CodethinkLabs/bloodlight-hardware/hardware/plots/rev2/bloodlight_2_bottom.png

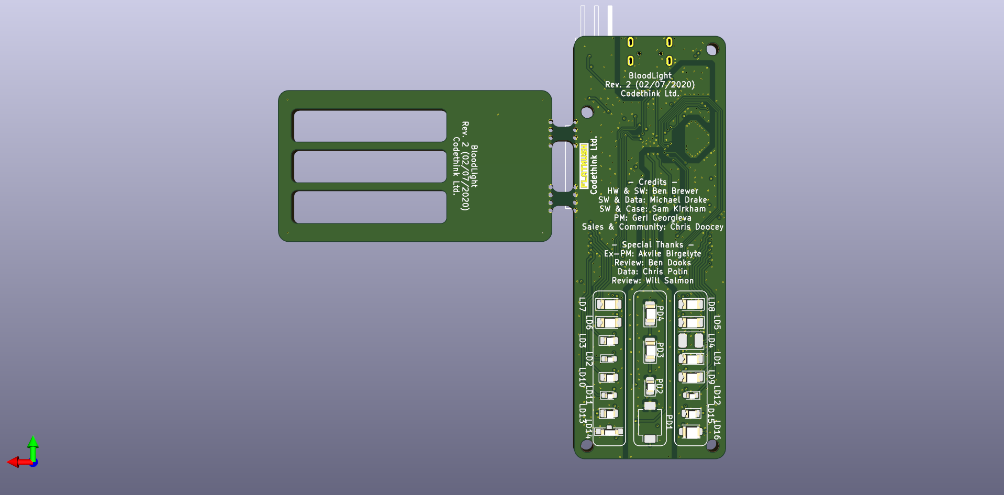
hardware/plots/rev2/bloodlight_2_bottom.png
