CodethinkLabs/bloodlight-hardware/hardware/plots/rev2/bloodlight_2_top.png

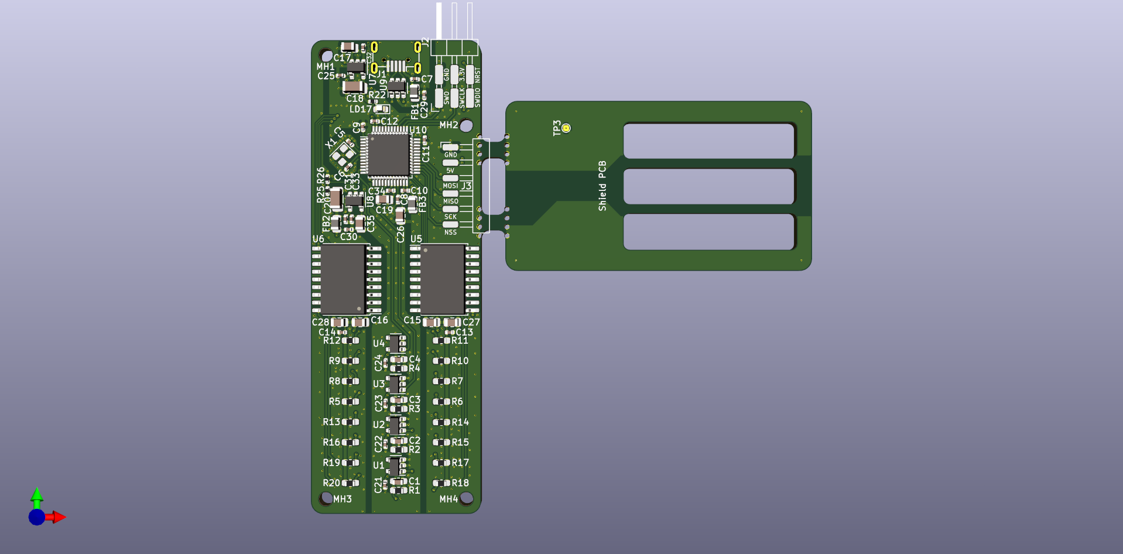
hardware/plots/rev2/bloodlight_2_top.png
