CodethinkLabs/bloodlight-hardware/hardware/pin_alloc.txt

# SIGNALS

VOLT:   VOLT_5V0
LED:    LED1..LED16, LED_STATUS
PD:     PDV1..PDV4
EXT:    SPI2_NSS, SPI2_SCK, SPI2_MISO, SPI2_MOSI
DEBUG:  SWCLK, SWDIO, SWO, NRST
USB:    USB_DP, USB_DM

# PINS

 1: VBAT
 2: PC13: LED2
 3: PC14: LED1
 4: PC15: LED11
 5: PF0 : OSC_IN
 6: PF1 : OSC_OUT
 7: PG10: NRST
 8: PA0 : LED12
 9: PA1 : LED15
10: PA2 : LED16
11: PA3 : PDV4 (ADC1_IN4, OPAMP1_VINM, OPAMP5_VINM)
12: PA4 : Not Connected (Isolation)
13: PA5 : LED8
14: PA6 : LED5
15: PA7 : VOLT_5V0 (ADC2_IN4, OPAMP1_VINP, OPAMP2_VINP)
16: PB0 : Not Connected (Isolation)
17: PB1 : PDV3 (ADC3_IN1, ADC1_IN12, OPAMP6_VINM)
18: PB2 : PDV1 (ADC2_IN12, OPAMP3_VINM)
19: VSSA
20: VREF+
21: VDDA
22: PB10: PDV2 (OPAMP3_VINM, OPAMP4_VINM)
23: VSS
24: VDD
25: PB11: LED3
26: PB12: SPI2_NSS
27: PB13: SPI2_SCK
28: PB14: SPI2_MISO
29: PB15: SPI2_MOSI (OPAMP5_VINM)
30: PA8 : LED6
31: PA9 : LED7
32: PA10: LED4
33: PA11: USB_DM
34: PA12: USB_DP
35: VSS
36: VDD
37: PA13: SWDIO
38: PA14: SWCLK
39: PA15: LED13
40: PB3 : SWO
41: PB4 : LED14
42: PB5 : LED9
43: PB6 : LED10
44: PB7 : LED_STATUS
45: PB8 : Unallocated (BOOT0)
46: PB9 : Unallocated
47: VSS
48: VDD
