CodethinkLabs/bloodlight-hardware/hardware/plots/rev2/bloodlight_2_angle.png

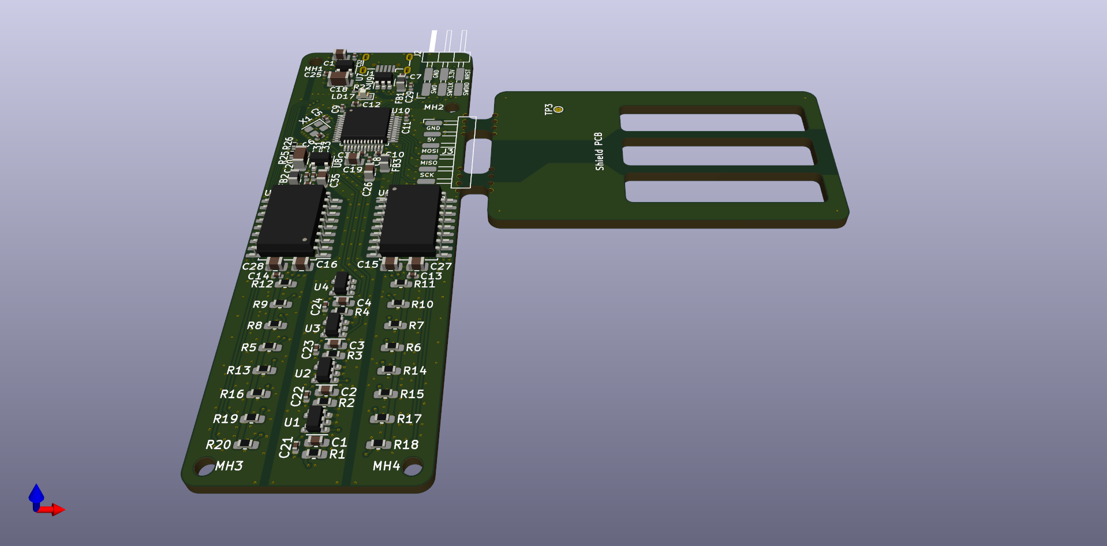
hardware/plots/rev2/bloodlight_2_angle.png
