CodethinkLabs/bloodlight-hardware/doc/LED.ods

Sheet: Components
Wavelength (nm) | Color | Price (£) | Availability | Voltage | Current (mA) | Power (mW) | Length (mm) | Width (mm) | Height (mm) | PD1 | PD2 | PD3 | PD4 | Photodiode | Selected | Category | URL
1650 | SWIR | £17.00 | 38 | 1.00 | 50 | 50 | 3.20 | 1.60 | 1.20 | 0.00 | 0.00 | 0.00 | 0.73 | PD4 | LD8 | Infrared, UV, Visible Emitters | https://www.digikey.co.uk/product-detail/en/marktech-optoelectronics/MTSM5016-199-IR/1125-1354-ND/5872623
1550 | SWIR | £17.00 | 323 | 1.00 | 50 | 50 | 3.20 | 1.60 | 1.20 | 0.00 | 0.00 | 0.00 | 0.96 | PD4 | LD7 | Infrared, UV, Visible Emitters | https://www.digikey.co.uk/product-detail/en/marktech-optoelectronics/MTSM5015-199-IR/1125-1350-ND/5872619
1500 | SWIR | £18.59 | 1,240 | 1.05 | 50 | 52.5 | 3.30 | 3.30 | 1.95 | 0.00 | 0.00 | 0.00 | 0.95 | PD4 |  | Infrared, UV, Visible Emitters | https://www.digikey.co.uk/product-detail/en/qt-brightek-qtb/QBHP684E-IR1500B/1516-QBHP684E-IR1500BCT-ND/10441186
1450 | SWIR | £17.00 | 30 | 1.00 | 50 | 50 | 3.20 | 1.60 | 1.20 | 0.00 | 0.00 | 0.00 | 0.94 | PD4 | LD6 | Infrared, UV, Visible Emitters | https://www.digikey.co.uk/product-detail/en/marktech-optoelectronics/MTSM5014-199-IR/1125-1346-ND/5872615
1300 | NIR | £17.00 | 4 | 1.00 | 50 | 50 | 3.20 | 1.60 | 1.20 | 0.00 | 0.00 | 0.00 | 0.86 | PD4 |  | Infrared, UV, Visible Emitters | https://www.digikey.co.uk/product-detail/en/marktech-optoelectronics/MTSM0013-199-IR/1125-1335-ND/5872604
1300 | NIR | £14.07 | 200 | 1.03 | 50 | 51.5 | 3.50 | 2.70 | 1.80 | 0.00 | 0.00 | 0.00 | 0.86 | PD4 |  | Infrared, UV, Visible Emitters | https://www.digikey.co.uk/product-detail/en/marktech-optoelectronics/MTSM1300MT2-BK/1125-MTSM1300MT2-BKCT-ND/11307539
1200 | NIR | £17.00 | 94 | 1.00 | 50 | 50 | 3.20 | 1.60 | 1.20 | 0.00 | 0.00 | 0.00 | 0.80 | PD4 | LD5 | Infrared, UV, Visible Emitters | https://www.digikey.co.uk/product-detail/en/marktech-optoelectronics/MTSM0012-199-IR/1125-1331-ND/5872600
1070 | NIR | £14.07 | 200 | 1.32 | 100 | 132 | 3.50 | 2.70 | 1.80 | 0.04 | 0.14 | 0.39 | 0.69 | PD4 |  | Infrared, UV, Visible Emitters | https://www.digikey.co.uk/product-detail/en/marktech-optoelectronics/MTSM7110MT2-BK/1125-MTSM7110MT2-BKCT-ND/11307532
1050 | NIR | £15.05 | 124 | 1.20 | 50 | 60 | 3.20 | 1.60 | 1.20 | 0.05 | 0.21 | 0.54 | 0.68 | PD4 |  | Infrared, UV, Visible Emitters | https://www.digikey.co.uk/product-detail/en/marktech-optoelectronics/MTSM5010-199-IR/1125-1342-ND/5872611
1040 | NIR | £14.07 | 200 | 1.03 | 100 | 103 | 3.50 | 2.70 | 1.80 | 0.05 | 0.24 | 0.62 | 0.67 | PD4 | LD4 | Infrared, UV, Visible Emitters | https://www.digikey.co.uk/product-detail/en/marktech-optoelectronics/MTSM4110MT2-BK/1125-MTSM4110MT2-BKCT-ND/11307533
1020 | NIR | £37.48 | 47 | 1.00 | 500 | 500 | 3.80 | 3.80 | 0.90 | 0.05 | 0.30 | 0.77 | 0.66 | PD3 |  | Infrared, UV, Visible Emitters | https://www.digikey.co.uk/product-detail/en/marktech-optoelectronics/MTSM2010-496-IR/1125-1358-ND/5872627
980 | NIR | £33.05 | 9 | 1.45 | 30 | 43.5 | 3.50 | 2.20 | 1.24 | 0.07 | 0.46 | 0.95 | 0.57 | PD3 |  | Infrared, UV, Visible Emitters | https://www.digikey.co.uk/product-detail/en/marktech-optoelectronics/MTPS2097MC/1125-1451-ND/9598984
980 | NIR | £43.97 | 39 | 2.00 | 80 | 160 | 3.50 | 2.20 | 1.91 | 0.07 | 0.46 | 0.95 | 0.57 | PD3 |  | Infrared, UV, Visible Emitters | https://www.digikey.co.uk/product-detail/en/marktech-optoelectronics/MTE9730CP/1125-1435-ND/8566064
950 | NIR | £0.84 | 14,970 | 1.60 | 70 | 112 | 3.10 | 2.25 | 1.60 | 0.08 | 0.60 | 0.99 | 0.46 | PD3 |  | Infrared, UV, Visible Emitters | https://www.digikey.co.uk/product-detail/en/osram-opto-semiconductors-inc/SFH-4641-Z/475-2872-1-ND/2207278
940 | NIR | £0.39 | 270,682 | 1.20 | 65 | 78 | 2.00 | 1.25 | 1.00 | 0.08 | 0.65 | 1.00 | 0.42 | PD3 | LD3 | Infrared, UV, Visible Emitters | https://www.digikey.co.uk/product-detail/en/everlight-electronics-co-ltd/IR17-21C-TR8/1080-1353-1-ND/2676087
890 | NIR | £0.88 | 2,918 | 1.80 | 100 | 180 | 2.00 | 1.25 | 0.80 | 0.12 | 0.85 | 0.95 | 0.33 | PD3 |  | Infrared, UV, Visible Emitters | https://www.digikey.co.uk/product-detail/en/vishay-semiconductor-opto-division/VSMY5890X01/751-VSMY5890X01CT-ND/10658274
880 | NIR | £0.43 | 6,807 | 1.30 | 50 | 65 | 1.60 | 0.80 | 0.75 | 0.13 | 0.87 | 0.94 | 0.30 | PD3 | LD2 | Infrared, UV, Visible Emitters | https://www.digikey.co.uk/product-detail/en/kingbright/APT1608SF4C-PRV/754-1859-1-ND/4977031
875 | NIR | £0.36 | 2,075 | 1.30 | 65 | 84.5 | 1.20 | 0.80 | 0.80 | 0.13 | 0.88 | 0.93 | 0.29 | PD3 |  | Infrared, UV, Visible Emitters | https://www.digikey.co.uk/product-detail/en/everlight-electronics-co-ltd/SIR19-21C-TR8/1080-1425-1-ND/2676159
870 | NIR | £0.59 | 4,980 | 1.40 | 50 | 70 | 3.00 | 1.50 | 1.50 | 0.14 | 0.89 | 0.93 | 0.28 | PD3 |  | Infrared, UV, Visible Emitters | https://www.digikey.co.uk/product-detail/en/stanley-electric-co/TDN1101W-TR/404-1285-1-ND/9477290
860 | NIR | £0.93 | 363,442 | 1.50 | 100 | 150 | 1.70 | 0.80 | 0.65 | 0.15 | 0.92 | 0.92 | 0.25 | PD2 |  | Infrared, UV, Visible Emitters | https://www.digikey.co.uk/product-detail/en/osram-opto-semiconductors-inc/SFH-4050-Z/475-2864-1-ND/2207282
855 | NIR | £13.36 | 4 | 1.70 | 100 | 170 | 3.50 | 2.20 | 1.24 | 0.15 | 0.93 | 0.91 | 0.24 | PD2 |  | Infrared, UV, Visible Emitters | https://www.digikey.co.uk/product-detail/en/marktech-optoelectronics/MTPS3085MC/1125-1033-ND/2798899
855 | NIR | £3.57 | 400 | 3.20 | 1000 | 3200 | 3.50 | 3.50 | 2.36 | 0.15 | 0.93 | 0.91 | 0.24 | PD2 |  | Infrared, UV, Visible Emitters | https://www.digikey.co.uk/product-detail/en/everlight-electronics-co-ltd/HIR-C19D-1N90-L558-P03-TR/1080-HIR-C19D-1N90-L558-P03-CT-ND/10473839
850 | NIR | £0.54 | 7,135 | 1.45 | 50 | 72.5 | 3.00 | 1.50 | 1.50 | 0.15 | 0.94 | 0.90 | 0.23 | PD2 | LD1 | Infrared, UV, Visible Emitters | https://www.digikey.co.uk/product-detail/en/stanley-electric-co/HDN1102W-TR/404-1329-1-ND/9477334
830 | NIR | £1.15 | 8,016 | 1.50 | 100 | 150 | 3.50 | 2.80 | 1.75 | 0.17 | 0.98 | 0.88 | 0.18 | PD2 |  | Infrared, UV, Visible Emitters | https://www.digikey.co.uk/product-detail/en/vishay-semiconductor-opto-division/VSMG2700-GS08/751-1255-1-ND/1681497
820 | NIR | £5.15 | 2,929 | 3.30 | 500 | 1650 | 3.50 | 3.50 | 2.39 | 0.18 | 1.00 | 0.87 | 0.15 | PD2 |  | Infrared, UV, Visible Emitters | https://www.digikey.co.uk/product-detail/en/osram-opto-semiconductors-inc/SFH-4780S/475-3592-1-ND/9468179
820 | NIR | £5.15 | 1,686 | 3.30 | 500 | 1650 | 3.50 | 3.50 | 1.75 | 0.18 | 1.00 | 0.87 | 0.15 | PD2 |  | Infrared, UV, Visible Emitters | https://www.digikey.co.uk/product-detail/en/osram-opto-semiconductors-inc/SFH-4787S/475-3549-1-ND/9383832
815 | NIR | £3.76 | 987 | 3.00 | 1500 | 4500 | 3.50 | 3.50 | 1.90 | 0.19 | 1.00 | 0.86 | 0.15 | PD2 |  | Infrared, UV, Visible Emitters | https://www.digikey.co.uk/product-detail/en/luminus-devices-inc/SST-10-IRD-B130-S810/1214-SST-10-IRD-B130-S810CT-ND/10521440
810 | NIR | £32.97 | 10 | 1.55 | 80 | 124 | 3.50 | 2.20 | 1.91 | 0.20 | 1.00 | 0.85 | 0.15 | PD2 |  | Infrared, UV, Visible Emitters | https://www.digikey.co.uk/product-detail/en/marktech-optoelectronics/MTE8120CP/1125-1433-ND/8566062
770 | NIR | £2.87 | 842 | 1.70 | 30 | 51 | 3.20 | 1.60 | 1.20 | 0.29 | 0.92 | 0.61 | 0.12 | PD2 |  | Infrared, UV, Visible Emitters | https://www.digikey.co.uk/product-detail/en/marktech-optoelectronics/MTSM0077-843-IR/1125-1337-ND/5872606
740 | Red | £2.87 | 734 | 1.70 | 30 | 51 | 3.20 | 1.60 | 1.20 | 0.36 | 0.85 | 0.40 | 0.10 | PD2 | LD9 | Infrared, UV, Visible Emitters | https://www.digikey.co.uk/product-detail/en/marktech-optoelectronics/MTSM0074-843-IR/1125-1336-ND/5872605
740 | Red | £4.37 | 513 | 1.90 | 700 | 1330 | 3.50 | 3.50 | 2.00 | 0.36 | 0.85 | 0.40 | 0.10 | PD2 |  | Infrared, UV, Visible Emitters | https://www.digikey.co.uk/product-detail/en/qt-brightek-qtb/QBHP684-IR4BU/1516-1213-1-ND/6151901
735 | Red | £2.52 | 1,087 | 1.73 | 350 | 605.5 | 2.00 | 2.00 | 1.50 | 0.37 | 0.84 | 0.36 | 0.10 | PD2 |  | LED Lighting – Color | https://www.digikey.co.uk/product-detail/en/lumileds/L1C1-FRD1000000000/1416-1913-1-ND/5872096
730 | Red | £0.53 | 6,496 | 2.15 | 120 | 258 | 3.50 | 2.80 | 0.75 | 0.38 | 0.83 | 0.33 | 0.10 | PD2 |  | LED Lighting – Color | https://www.digikey.co.uk/product-detail/en/lumileds/L1SP-FRD0002800000/1416-2055-1-ND/9805577
660 | Red | £2.15 | 899 | 2.30 | 3000 | 6900 | 3.45 | 3.45 | 1.84 | 0.65 | 0.71 | 0.07 | 0.05 | PD2 |  | Infrared, UV, Visible Emitters | https://www.digikey.co.uk/product-detail/en/luminus-devices-inc/SST-20-DR-B120-V660/1214-SST-20-DR-B120-V660CT-ND/10521452
660 | Red | £0.22 | 149,792 | 1.80 | 20 | 36 | 2.00 | 1.25 | 0.90 | 0.65 | 0.71 | 0.07 | 0.05 | PD2 | LD10 | LED Indication – Discrete | https://www.digikey.co.uk/product-detail/en/osram-opto-semiconductors-inc/LH-R974-LP-1/475-1415-1-ND/1802604
660 | Red | £0.51 | 5,486 | 2.15 | 120 | 258 | 3.50 | 2.80 | 0.75 | 0.65 | 0.71 | 0.07 | 0.05 | PD2 |  | LED Lighting – Color | https://www.digikey.co.uk/product-detail/en/lumileds/L1SP-DRD0002800000/1416-2056-1-ND/9805578
655 | Red | £0.32 | 27,746 | 1.80 | 20 | 36 | 1.60 | 0.80 | 0.75 | 0.68 | 0.70 | 0.06 | 0.04 | PD2 |  | LED Indication – Discrete | https://www.digikey.co.uk/product-detail/en/kingbright/APT1608SRCPRV/754-1122-1-ND/1747839
655 | Red | £2.68 | 1,703 | 2.10 | 350 | 735 | 4.49 | 3.05 | 2.10 | 0.68 | 0.70 | 0.06 | 0.04 | PD2 |  | LED Lighting – Color | https://www.digikey.co.uk/product-detail/en/lumileds/LXM3-PD01/1416-1701-1-ND/5440991
652 | Red | £0.37 | 3,000 | 2.10 | 20 | 42 | 2.00 | 1.40 | 1.31 | 0.69 | 0.70 | 0.06 | 0.04 | PD2 |  | LED Indication – Discrete | https://www.digikey.co.uk/product-detail/en/w%C3%BCrth-elektronik/150224SS73100/732-11399-1-ND/7316025
650 | Red | £15.16 | 35 | 1.90 | 50 | 95 | 3.50 | 2.20 | 1.24 | 0.71 | 0.70 | 0.06 | 0.04 | PD1 |  | Infrared, UV, Visible Emitters | https://www.digikey.co.uk/product-detail/en/marktech-optoelectronics/MTPS7065MC/1125-1151-ND/3973514
650 | Red | £0.37 | 10,783 | 1.95 | 20 | 39 | 3.20 | 1.60 | 1.10 | 0.71 | 0.70 | 0.06 | 0.04 | PD1 |  | LED Indication – Discrete | https://www.digikey.co.uk/product-detail/en/kingbright/AP3216SURCK/754-2162-1-ND/7708877
645 | Red | £0.23 | 203,073 | 2.00 | 20 | 40 | 2.00 | 1.25 | 0.90 | 0.73 | 0.69 | 0.05 | 0.04 | PD1 |  | LED Indication – Discrete | https://www.digikey.co.uk/product-detail/en/osram-opto-semiconductors-inc/LS-R976-NR-1/475-1278-1-ND/1642798
643 | Red | £0.35 | 5,318 | 2.20 | 20 | 44 | 1.40 | 0.80 | 0.70 | 0.74 | 0.69 | 0.05 | 0.03 | PD1 |  | LED Indication – Discrete | https://www.digikey.co.uk/product-detail/en/osram-opto-semiconductors-inc/KS-DELPS1-22-TIVH-68-H3Q4-20-S/475-3714-1-ND/9999415
641 | Red | £0.47 | 6,917 | 2.00 | 30 | 60 | 3.00 | 2.80 | 1.85 | 0.75 | 0.68 | 0.05 | 0.03 | PD1 |  | LED Indication – Discrete | https://www.digikey.co.uk/product-detail/en/vishay-semiconductor-opto-division/VLMS33S1U1-GS08/VLMS33S1U1-GS08CT-ND/8556897
640 | Red | £0.47 | 6,671 | 2.20 | 20 | 44 | 2.00 | 1.25 | 1.20 | 0.76 | 0.68 | 0.04 | 0.03 | PD1 |  | LED Indication – Discrete | https://www.digikey.co.uk/product-detail/en/sunled/XZM2CRK54WA-8/1497-1450-1-ND/8571170
639 | Red | £0.35 | 4,350 | 2.00 | 20 | 40 | 3.20 | 1.60 | 1.10 | 0.76 | 0.68 | 0.04 | 0.03 | PD1 |  | LED Indication – Discrete | https://www.digikey.co.uk/product-detail/en/lite-on-inc/LTST-C21KRKT/160-2024-1-ND/3711415
638 | Red | £0.35 | 3,020 | 2.10 | 20 | 42 | 1.60 | 0.80 | 0.80 | 0.77 | 0.68 | 0.04 | 0.03 | PD1 | LD11 | LED Indication – Discrete | https://www.digikey.co.uk/product-detail/en/stanley-electric-co/FKR1111C-TR/404-1269-1-ND/9477274
637 | Red | £0.60 | 19,421 | 2.00 | 20 | 40 | 1.60 | 0.80 | 0.70 | 0.77 | 0.68 | 0.04 | 0.03 | PD1 |  | LED Indication – Discrete | https://www.digikey.co.uk/product-detail/en/broadcom-limited/HSMC-C191-T0000/516-HSMC-C191-T0000CT-ND/10511670
636 | Red | £0.42 | 46,481 | 2.00 | 20 | 40 | 1.60 | 0.80 | 0.55 | 0.78 | 0.68 | 0.04 | 0.03 | PD1 |  | LED Indication – Discrete | https://www.digikey.co.uk/product-detail/en/broadcom-limited/ASMT-RR45-AQ902/516-2005-1-ND/1990536
635 | Red | £0.27 | 15,453 | 2.00 | 20 | 40 | 1.60 | 0.80 | 0.65 | 0.78 | 0.68 | 0.04 | 0.03 | PD1 |  | LED Indication – Discrete | https://www.digikey.co.uk/product-detail/en/visual-communications-company-vcc/LSM0603412V/LSM0603412VCT-ND/9486727
634 | Red | £0.37 | 128,171 | 2.05 | 20 | 41 | 3.20 | 2.80 | 2.10 | 0.79 | 0.67 | 0.04 | 0.03 | PD1 |  | LED Indication – Discrete | https://www.digikey.co.uk/product-detail/en/osram-opto-semiconductors-inc/LR-T68F-U1AA-1-1-Z/475-2820-1-ND/2176359
633 | Red | £0.76 | 15,667 | 2.30 | 150 | 345 | 2.80 | 3.40 | 0.90 | 0.79 | 0.67 | 0.04 | 0.03 | PD1 |  | LED Indication – Discrete | https://www.digikey.co.uk/product-detail/en/broadcom-limited/ASMW-LR00-ASU0E/516-4340-1-ND/10239767
633 | Red | £2.09 | 3,860 | 2.20 | 500 | 1100 | 1.70 | 1.30 | 0.66 | 0.79 | 0.67 | 0.04 | 0.03 | PD1 |  | LED Lighting – Color | https://www.digikey.co.uk/product-detail/en/lumileds/LXZ1-PD01/1416-1053-1-ND/3961158
632 | Red | £0.42 | 78,440 | 2.00 | 20 | 40 | 2.20 | 1.40 | 1.40 | 0.80 | 0.67 | 0.04 | 0.03 | PD1 |  | LED Indication – Discrete | https://www.digikey.co.uk/product-detail/en/vishay-semiconductor-opto-division/VLMR233T2V2-GS08/VLMR233T2V2-GS08CT-ND/3025481
632 | Red | £1.39 | 1,684 | 2.29 | 350 | 801.5 | 2.75 | 2.00 | 0.70 | 0.80 | 0.67 | 0.04 | 0.03 | PD1 |  | LED Lighting – Color | https://www.digikey.co.uk/product-detail/en/osram-opto-semiconductors-inc/KS-DMLQ31-23-GZJY-68-J3T3-Z/475-3377-1-ND/7907972
631 | Red | £0.34 | 4 | 2.00 | 20 | 40 | 3.00 | 1.40 | 1.20 | 0.80 | 0.67 | 0.03 | 0.02 | PD1 |  | LED Indication – Discrete | https://www.digikey.co.uk/product-detail/en/lite-on-inc/LTST-M140QEKT/160-2229-1-ND/7708903
630 | Red | £18.22 | 62 | 2.10 | 15 | 31.5 | 3.50 | 2.20 | 1.24 | 0.81 | 0.67 | 0.03 | 0.02 | PD1 |  | Infrared, UV, Visible Emitters | https://www.digikey.co.uk/product-detail/en/marktech-optoelectronics/MTPS9062MC-BK/1125-1431-ND/8566060
630 | Red | £0.12 | 103,068 | 2.00 | 20 | 40 | 1.60 | 0.80 | 0.80 | 0.81 | 0.67 | 0.03 | 0.02 | PD1 |  | LED Indication – Discrete | https://www.digikey.co.uk/product-detail/en/w%C3%BCrth-elektronik/150060RS75000/732-4978-1-ND/4489899
629 | Red | £0.28 | 1,147 | 2.20 | 20 | 44 | 3.20 | 2.80 | 2.10 | 0.81 | 0.67 | 0.03 | 0.02 | PD1 |  | LED Indication – Discrete | https://www.digikey.co.uk/product-detail/en/w%C3%BCrth-elektronik/150141RS73113/732-13433-1-ND/9858011
627 | Red | £0.32 | 8,905 | 2.00 | 20 | 40 | 2.70 | 2.00 | 1.50 | 0.82 | 0.67 | 0.03 | 0.02 | PD1 |  | LED Indication – Discrete | https://www.digikey.co.uk/product-detail/en/kingbright/AA3021ES/754-1523-1-ND/2438921
627 | Red | £2.94 | 3,347 | 2.10 | 350 | 735 | 4.49 | 3.05 | 2.10 | 0.82 | 0.67 | 0.03 | 0.02 | PD1 |  | LED Lighting – Color | https://www.digikey.co.uk/product-detail/en/lumileds/LXM2-PD01-0040/1416-1023-1-ND/3961128
626 | Red | £1.70 | 1,374 | 2.15 | 350 | 752.5 | 3.75 | 3.75 | 0.80 | 0.83 | 0.66 | 0.03 | 0.02 | PD1 |  | LED Lighting – Color | https://www.digikey.co.uk/product-detail/en/osram-opto-semiconductors-inc/LR-H9PP-HZJZ-1-1-350-R18-Z/475-3761-1-ND/10055042
625 | Red | £0.39 | 2,710 | 2.00 | 20 | 40 | 2.00 | 1.25 | 0.90 | 0.83 | 0.66 | 0.03 | 0.02 | PD1 |  | LED Indication – Discrete | https://www.digikey.co.uk/product-detail/en/visual-communications-company-vcc/LSM0805412V/28-LSM0805412VCT-ND/10229621
625 | Red | £2.60 | 1,000 | 2.20 | 350 | 770 | 3.50 | 3.50 | 2.13 | 0.83 | 0.66 | 0.03 | 0.02 | PD1 |  | LED Lighting – Color | https://www.digikey.co.uk/product-detail/en/inolux/IN-C33CTLR/1830-1169-1-ND/9681249
624 | Red | £0.47 | 2,041 | 1.90 | 20 | 38 | 1.60 | 0.80 | 0.80 | 0.84 | 0.66 | 0.03 | 0.02 | PD1 |  | LED Indication – Discrete | https://www.digikey.co.uk/product-detail/en/stanley-electric-co/VFHV1111C-3BY2B-TR/404-1313-1-ND/9477318
624 | Red | £1.51 | 567 | 2.15 | 350 | 752.5 | 3.00 | 3.00 | 1.82 | 0.84 | 0.66 | 0.03 | 0.02 | PD1 |  | LED Lighting – Color | https://www.digikey.co.uk/product-detail/en/osram-opto-semiconductors-inc/LJ-CKBP-JYKY-36-1-350-R18-Z/475-3756-1-ND/10055037
623 | Red | £0.92 | 88 | 2.20 | 50 | 110 | 3.20 | 2.80 | 2.10 | 0.84 | 0.66 | 0.03 | 0.02 | PD1 |  | LED Indication – Discrete | https://www.digikey.co.uk/product-detail/en/stanley-electric-co/VFSV1104LS-TR/404-1323-1-ND/9477328
623 | Red | £1.33 | 2,111 | 2.20 | 350 | 770 | 1.60 | 1.60 | 1.73 | 0.84 | 0.66 | 0.03 | 0.02 | PD1 |  | LED Lighting – Color | https://www.digikey.co.uk/product-detail/en/cree-inc/XQERED-00-0000-000000702/XQERED-00-0000-000000702CT-ND/5725144
622 | Red | £0.34 | 2,420 | 2.00 | 20 | 40 | 2.20 | 1.40 | 1.40 | 0.85 | 0.66 | 0.02 | 0.02 | PD1 |  | LED Indication – Discrete | https://www.digikey.co.uk/product-detail/en/osram-opto-semiconductors-inc/LA-M676-Q2T1-24/475-3730-1-ND/10055011
621 | Red | £0.32 | 20,669 | 2.00 | 20 | 40 | 1.60 | 0.80 | 0.90 | 0.85 | 0.66 | 0.02 | 0.02 | PD1 |  | LED Indication – Discrete | https://www.digikey.co.uk/product-detail/en/lite-on-inc/LTST-C190KAKT/160-1433-1-ND/386810
621 | Red | £1.13 | 2,084 | 2.32 | 350 | 812 | 2.75 | 2.00 | 0.70 | 0.85 | 0.66 | 0.02 | 0.02 | PD1 |  | LED Lighting – Color | https://www.digikey.co.uk/product-detail/en/osram-opto-semiconductors-inc/KR-DMLQ31-23-HYKY-26-J3T3-Z/475-3376-1-ND/7907968
620 | Red | £0.68 | 4,870 | 2.20 | 20 | 44 | 3.00 | 2.00 | 1.30 | 0.86 | 0.66 | 0.02 | 0.02 | PD1 |  | LED Indication – Discrete | https://www.digikey.co.uk/product-detail/en/dialight/5973032507F/350-2326-1-ND/2442839
620 | Red | £1.51 | 212 | 2.15 | 350 | 752.5 | 3.00 | 3.00 | 1.82 | 0.86 | 0.66 | 0.02 | 0.02 | PD1 |  | LED Lighting – Color | https://www.digikey.co.uk/product-detail/en/osram-opto-semiconductors-inc/LJ-CKBP-JZKZ-25-1-350-R18-Z/475-3757-1-ND/10055038
618 | Orange | £0.38 | 3,152 | 2.15 | 20 | 43 | 2.00 | 1.40 | 1.40 | 0.87 | 0.65 | 0.02 | 0.01 | PD1 |  | LED Lighting – Color | https://www.digikey.co.uk/product-detail/en/osram-opto-semiconductors-inc/LA-M67F-V1AB-24-Z/475-3396-1-ND/7907995
617 | Orange | £1.66 | 429 | 2.20 | 350 | 770 | 3.75 | 3.75 | 2.41 | 0.87 | 0.65 | 0.02 | 0.01 | PD1 |  | LED Lighting – Color | https://www.digikey.co.uk/product-detail/en/osram-opto-semiconductors-inc/LA-H9GP-JYKZ-24-H29C-350-R18-Z/475-3729-ND/9857695
616 | Orange | £0.85 | 457 | 2.20 | 140 | 308 | 3.50 | 3.50 | 1.40 | 0.88 | 0.65 | 0.02 | 0.01 | PD1 |  | LED Lighting – Color | https://www.digikey.co.uk/product-detail/en/vishay-semiconductor-opto-division/VLMK51Z1AA-GS08/751-VLMK51Z1AA-GS08CT-ND/3340214
615 | Orange | £0.34 | 2,975 | 1.80 | 2 | 3.6 | 2.20 | 1.40 | 1.40 | 0.88 | 0.65 | 0.02 | 0.01 | PD1 |  | LED Indication – Discrete | https://www.digikey.co.uk/product-detail/en/vishay-semiconductor-opto-division/VLMK20J2L2-GS08/VLMK20J2L2-GS08CT-ND/9663848
615 | Orange | £0.28 | 1,696 | 2.20 | 20 | 44 | 3.20 | 2.80 | 2.10 | 0.88 | 0.65 | 0.02 | 0.01 | PD1 |  | LED Indication – Discrete | https://www.digikey.co.uk/product-detail/en/w%C3%BCrth-elektronik/150141AS73113/732-13434-1-ND/9858012
615 | Orange | £0.92 | 1,235 | 2.20 | 350 | 770 | 1.60 | 1.60 | 1.73 | 0.88 | 0.65 | 0.02 | 0.01 | PD1 |  | LED Lighting – Color | https://www.digikey.co.uk/product-detail/en/cree-inc/XQERDO-H2-0000-000000701/XQERDO-H2-0000-000000701CT-ND/5423132
613 | Orange | £1.17 | 574 | 2.20 | 350 | 770 | 1.60 | 1.60 | 1.73 | 0.89 | 0.65 | 0.01 | 0.01 | PD1 |  | LED Lighting – Color | https://www.digikey.co.uk/product-detail/en/cree-inc/XQERDO-00-0000-000000802/XQERDO-00-0000-000000802CT-ND/5806215
612 | Orange | £0.36 | 51,980 | 2.00 | 20 | 40 | 1.60 | 0.80 | 0.55 | 0.90 | 0.65 | 0.01 | 0.01 | PD1 | LD12 | LED Indication – Discrete | https://www.digikey.co.uk/product-detail/en/broadcom-limited/ASMT-RJ45-AQ502/516-ASMT-RJ45-AQ502CT-ND/10511987
611 | Orange | £0.20 | 107,552 | 2.00 | 20 | 40 | 1.60 | 0.80 | 0.65 | 0.90 | 0.64 | 0.01 | 0.01 | PD1 |  | LED Indication – Discrete | https://www.digikey.co.uk/product-detail/en/lite-on-inc/LTST-C191KFKT/160-1445-1-ND/386832
610 | Orange | £0.37 | 61,589 | 2.10 | 20 | 42 | 1.60 | 0.80 | 1.10 | 0.91 | 0.64 | 0.01 | 0.01 | PD1 |  | LED Indication – Discrete | https://www.digikey.co.uk/product-detail/en/kingbright/APTD1608SECK/754-1860-1-ND/4977032
609 | Orange | £0.28 | 7,783 | 2.00 | 20 | 40 | 1.60 | 0.80 | 0.60 | 0.91 | 0.64 | 0.01 | 0.01 | PD1 |  | LED Indication – Discrete | https://www.digikey.co.uk/product-detail/en/inolux/IN-S63BTA/1830-1071-1-ND/7604712
608 | Orange | £0.41 | 2,234 | 1.90 | 20 | 38 | 3.00 | 1.50 | 1.50 | 0.92 | 0.64 | 0.01 | 0.01 | PD1 |  | LED Indication – Discrete | https://www.digikey.co.uk/product-detail/en/stanley-electric-co/VFA1101W-5AY3B2-TR/404-1234-1-ND/7594912
605 | Orange | £0.68 | 3,806 | 2.20 | 20 | 44 | 3.00 | 2.00 | 1.30 | 0.93 | 0.64 | 0.01 | 0.00 | PD1 |  | LED Indication – Discrete | https://www.digikey.co.uk/product-detail/en/dialight/5973202507F/350-2327-1-ND/2442841
603 | Orange | £0.37 | 4,715 | 2.00 | 5 | 10 | 1.00 | 0.50 | 0.50 | 0.94 | 0.63 | 0.00 | 0.00 | PD1 |  | LED Indication – Discrete | https://www.digikey.co.uk/product-detail/en/inolux/IN-S42BT5A/1830-IN-S42BT5ACT-ND/10384851
600 | Orange | £0.32 | 55,996 | 2.20 | 20 | 44 | 3.20 | 2.80 | 2.10 | 0.96 | 0.63 | 0.00 | 0.00 | PD1 |  | LED Indication – Discrete | https://www.digikey.co.uk/product-detail/en/broadcom-limited/HSMD-A100-J00J1/516-HSMD-A100-J00J1CT-ND/10511714 | 0.96
597 | Orange | £0.39 | 5,619 | 2.20 | 20 | 44 | 2.00 | 1.40 | 1.40 | 0.96 | 0.62 | 0.00 | 0.00 | PD1 |  | LED Indication – Discrete | https://www.digikey.co.uk/product-detail/en/osram-opto-semiconductors-inc/LY-M67F-T2V2-36-Z/475-3465-1-ND/7908094
595 | Orange | £0.62 | 19,980 | 2.00 | 20 | 40 | 2.00 | 1.25 | 0.90 | 0.97 | 0.62 | 0.00 | 0.00 | PD1 |  | LED Indication – Discrete | https://www.digikey.co.uk/product-detail/en/broadcom-limited/HSMA-C170-T0000/516-HSMA-C170-T0000CT-ND/10511665
594 | Orange | £0.30 | 3,472 | 2.00 | 20 | 40 | 3.20 | 1.50 | 1.10 | 0.97 | 0.61 | 0.00 | 0.00 | PD1 |  | LED Indication – Discrete | https://www.digikey.co.uk/product-detail/en/inolux/IN-S126ATY/1830-1093-1-ND/7604683
593 | Orange | £0.35 | 4,530 | 2.30 | 20 | 46 | 1.40 | 0.80 | 0.70 | 0.97 | 0.61 | 0.00 | 0.00 | PD1 |  | LED Indication – Discrete | https://www.digikey.co.uk/product-detail/en/osram-opto-semiconductors-inc/KY-DELPS1-22-UGVI-36-J3S5-20-S/475-3712-1-ND/9999413
593 | Orange | £1.65 | 1,018 | 2.20 | 350 | 770 | 3.45 | 3.45 | 2.39 | 0.97 | 0.61 | 0.00 | 0.00 | PD1 |  | LED Lighting – Color | https://www.digikey.co.uk/product-detail/en/cree-inc/XPEBAM-L1-0000-00903/XPEBAM-L1-0000-00903CT-ND/5806127
592 | Orange | £0.17 | 5,576 | 2.00 | 20 | 40 | 2.00 | 1.40 | 1.41 | 0.97 | 0.61 | 0.00 | 0.00 | PD1 |  | LED Indication – Discrete | https://www.digikey.co.uk/product-detail/en/w%C3%BCrth-elektronik/150224YS73100A/732-12032-1-ND/8557242
591 | Orange | £0.23 | 63,658 | 2.00 | 20 | 40 | 2.00 | 1.25 | 0.90 | 0.97 | 0.61 | 0.00 | 0.00 | PD1 |  | LED Indication – Discrete | https://www.digikey.co.uk/product-detail/en/osram-opto-semiconductors-inc/LY-R976-PS-36/475-2560-1-ND/1802687
591 | Orange | £3.93 | 15,682 | 3.05 | 350 | 1067.5 | 4.49 | 3.05 | 2.10 | 0.97 | 0.61 | 0.00 | 0.00 | PD1 |  | LED Lighting – Color | https://www.digikey.co.uk/product-detail/en/lumileds/LXM2-PL01-0000/1416-1027-1-ND/3961132
590 | Orange | £0.34 | 5,700 | 2.00 | 20 | 40 | 2.00 | 1.25 | 0.75 | 0.97 | 0.60 | 0.00 | 0.00 | PD1 | LD13 | LED Indication – Discrete | https://www.digikey.co.uk/product-detail/en/kingbright/APT2012SYCK/754-1134-1-ND/1747851
590 | Orange | £0.85 | 421 | 2.20 | 140 | 308 | 3.50 | 3.50 | 1.40 | 0.97 | 0.60 | 0.00 | 0.00 | PD1 |  | LED Lighting – Color | https://www.digikey.co.uk/product-detail/en/vishay-semiconductor-opto-division/VLMY51Z1AA-GS08/VLMY51Z1AA-GS08CT-ND/3340225
589 | Yellow | £0.47 | 38,746 | 2.10 | 20 | 42 | 3.20 | 1.60 | 1.10 | 0.97 | 0.60 | 0.00 | 0.00 | PD1 |  | LED Indication – Discrete | https://www.digikey.co.uk/product-detail/en/broadcom-limited/HSMY-C150/516-1442-1-ND/637766
589 | Yellow | £2.12 | 929 | 2.20 | 350 | 770 | 3.00 | 3.00 | 1.59 | 0.97 | 0.60 | 0.00 | 0.00 | PD1 |  | LED Lighting – Color | https://www.digikey.co.uk/product-detail/en/osram-opto-semiconductors-inc/GY-CSHPM1-23-KQKS-36-0-350-R18/475-3312-1-ND/6599101
588 | Yellow | £0.23 | 294,753 | 2.10 | 20 | 42 | 1.60 | 0.80 | 0.65 | 0.98 | 0.60 | 0.00 | 0.00 | PD1 |  | LED Indication – Discrete | https://www.digikey.co.uk/product-detail/en/lite-on-inc/LTST-C191KSKT/160-1448-1-ND/386838
588 | Yellow | £1.04 | 539 | 2.20 | 350 | 770 | 3.45 | 3.45 | 2.39 | 0.98 | 0.60 | 0.00 | 0.00 | PD1 |  | LED Lighting – Color | https://www.digikey.co.uk/product-detail/en/cree-inc/XPEBAM-L1-0000-00602/XPEBAM-L1-0000-00602CT-ND/5806123
586 | Yellow | £0.75 | 3,915 | 2.00 | 10 | 20 | 3.20 | 2.80 | 2.00 | 0.98 | 0.59 | 0.00 | 0.00 | PD1 |  | LED Indication – Discrete | https://www.digikey.co.uk/product-detail/en/dialight/5973401207F/350-1576-1-ND/809276
585 | Yellow | £0.52 | 27,116 | 2.10 | 20 | 42 | 3.00 | 2.00 | 1.50 | 0.98 | 0.59 | 0.00 | 0.00 | PD1 |  | LED Indication – Discrete | https://www.digikey.co.uk/product-detail/en/dialight/5973401507F/350-2435-1-ND/2810537
583 | Yellow | £0.47 | 49,761 | 2.20 | 20 | 44 | 3.20 | 2.80 | 2.10 | 0.98 | 0.58 | 0.00 | 0.00 | PD1 |  | LED Indication – Discrete | https://www.digikey.co.uk/product-detail/en/broadcom-limited/HSMY-A100-J00J1/516-2855-1-ND/3909287
580 | Yellow | £0.42 | 8,140 | 2.20 | 20 | 44 | 3.00 | 1.50 | 1.50 | 0.99 | 0.58 | 0.00 | 0.00 | PD1 |  | LED Indication – Discrete | https://www.digikey.co.uk/product-detail/en/stanley-electric-co/RAY1102W-745-TR/404-1230-1-ND/7594908
576 | Yellow | £0.27 | 2,704 | 2.00 | 20 | 40 | 2.00 | 1.25 | 1.10 | 0.99 | 0.57 | 0.00 | 0.00 | PD1 |  | LED Indication – Discrete | https://www.digikey.co.uk/product-detail/en/inolux/IN-S85ATYG/1830-1084-1-ND/7604726
575 | Yellow | £0.22 | 845,909 | 2.00 | 20 | 40 | 1.60 | 0.80 | 0.70 | 0.99 | 0.56 | 0.00 | 0.00 | PD1 |  | LED Indication – Discrete | https://www.digikey.co.uk/product-detail/en/everlight-electronics-co-ltd/19-213-G6C-AP2Q2-3T/1080-19-213-G6C-AP2Q2-3TCT-ND/11201031
574 | Yellow | £0.40 | 195,963 | 2.10 | 20 | 42 | 1.60 | 0.80 | 1.10 | 0.99 | 0.56 | 0.00 | 0.00 | PD1 |  | LED Indication – Discrete | https://www.digikey.co.uk/product-detail/en/kingbright/APTD1608CGCK/754-1545-1-ND/2514673
573 | Yellow | £0.57 | 90 | 2.00 | 20 | 40 | 3.20 | 2.80 | 2.10 | 1.00 | 0.56 | 0.00 | 0.00 | PD1 |  | LED Indication – Discrete | https://www.digikey.co.uk/product-detail/en/stanley-electric-co/VFJP1104LS-TR/404-1318-1-ND/9477323
572 | Yellow | £0.17 | 5,479 | 2.00 | 20 | 40 | 2.00 | 1.40 | 1.41 | 1.00 | 0.56 | 0.00 | 0.00 | PD1 |  | LED Indication – Discrete | https://www.digikey.co.uk/product-detail/en/w%C3%BCrth-elektronik/150224VS73100A/732-12031-1-ND/8557241
571 | Yellow | £0.33 | 12,544 | 2.00 | 20 | 40 | 1.60 | 0.80 | 0.65 | 1.00 | 0.55 | 0.00 | 0.00 | PD1 |  | LED Indication – Discrete | https://www.digikey.co.uk/product-detail/en/visual-communications-company-vcc/LSM0603453V/LSM0603453VCT-ND/9486729
570 | Yellow | £0.52 | 25,387 | 2.10 | 20 | 42 | 3.20 | 1.50 | 1.00 | 1.00 | 0.55 | 0.00 | 0.00 | PD1 | LD14 | LED Indication – Discrete | https://www.digikey.co.uk/product-detail/en/broadcom-limited/HSME-C110/516-3982-1-ND/8537290
568 | Green | £0.58 | 2,129 | 2.00 | 20 | 40 | 3.20 | 1.60 | 1.40 | 0.99 | 0.55 | 0.00 | 0.00 | PD1 |  | LED Indication – Discrete | https://www.digikey.co.uk/product-detail/en/bivar-inc/SM1206GC-IL/492-1697-1-ND/4172085
568 | Green | £3.39 | 1,689 | 2.85 | 500 | 1425 | 1.70 | 1.30 | 0.66 | 0.99 | 0.55 | 0.00 | 0.00 | PD1 |  | LED Lighting – Color | https://www.digikey.co.uk/product-detail/en/lumileds/LXZ1-PX01/1416-1186-1-ND/4626445
566 | Green | £0.53 | 27,741 | 1.90 | 20 | 38 | 3.20 | 2.80 | 2.10 | 0.99 | 0.54 | 0.00 | 0.00 | PD1 |  | LED Indication – Discrete | https://www.digikey.co.uk/product-detail/en/broadcom-limited/HSME-A100-L01J1/516-2490-1-ND/2744916
565 | Green | £0.68 | 7,050 | 2.10 | 20 | 42 | 3.00 | 2.00 | 1.30 | 0.98 | 0.54 | 0.00 | 0.00 | PD1 |  | LED Indication – Discrete | https://www.digikey.co.uk/product-detail/en/dialight/5973312507F/350-2328-1-ND/2442843
563 | Green | £0.51 | 2,807 | 2.00 | 20 | 40 | 2.00 | 1.20 | 1.10 | 0.98 | 0.54 | 0.00 | 0.00 | PD1 |  | LED Indication – Discrete | https://www.digikey.co.uk/product-detail/en/bivar-inc/SM0805UGC/492-1329-1-ND/2408561
562 | Green | £0.55 | 3,736 | 2.00 | 30 | 60 | 2.00 | 1.40 | 1.40 | 0.97 | 0.53 | 0.00 | 0.00 | PD1 |  | LED Indication – Discrete | https://www.digikey.co.uk/product-detail/en/osram-opto-semiconductors-inc/LP-M675-M2P1-25-Z/475-2497-1-ND/1802624
562 | Green | £0.51 | 576 | 2.10 | 20 | 42 | 3.20 | 2.80 | 2.10 | 0.97 | 0.53 | 0.00 | 0.00 | PD1 |  | LED Lighting – Color | https://www.digikey.co.uk/product-detail/en/osram-opto-semiconductors-inc/LP-T67F-P1R2-35-1-20-R18-Z/475-3760-1-ND/10055041
561 | Green | £0.40 | 3,301 | 2.05 | 20 | 41 | 1.00 | 0.50 | 0.25 | 0.97 | 0.53 | 0.00 | 0.00 | PD1 |  | LED Indication – Discrete | https://www.digikey.co.uk/product-detail/en/sunled/XZMYR68W-3/1497-1385-1-ND/8259062
560 | Green | £0.58 | 23,928 | 2.10 | 20 | 42 | 1.60 | 0.80 | 0.70 | 0.97 | 0.53 | 0.00 | 0.00 | PD1 |  | LED Indication – Discrete | https://www.digikey.co.uk/product-detail/en/dialight/5975312407NF/350-3776-1-ND/5032367
558 | Green | £0.52 | 47,401 | 2.20 | 10 | 22 | 3.20 | 2.80 | 2.10 | 0.96 | 0.53 | 0.00 | 0.00 | PD1 |  | LED Indication – Discrete | https://www.digikey.co.uk/product-detail/en/broadcom-limited/HSMG-A100-K72J2/516-2250-1-ND/2408236
555 | Green | £0.47 | 2,900 | 2.20 | 20 | 44 | 2.20 | 1.40 | 1.40 | 0.95 | 0.52 | 0.00 | 0.00 | PD1 |  | LED Indication – Discrete | https://www.digikey.co.uk/product-detail/en/vishay-semiconductor-opto-division/VLMP23L2M2-GS08/VLMP23L2M2-GS08CT-ND/9663858
532 | Green | £1.09 | 2,094 | 3.40 | 10 | 34 | 2.20 | 1.10 | 1.30 | 0.88 | 0.47 | 0.00 | 0.00 | PD1 |  | LED Lighting – Color | https://www.digikey.co.uk/product-detail/en/osram-opto-semiconductors-inc/LT-Y87S-P2S1-35-Z/475-3446-1-ND/7908064
530 | Green | £0.37 | 3,517 | 3.30 | 20 | 66 | 1.60 | 0.80 | 0.60 | 0.87 | 0.47 | 0.00 | 0.00 | PD1 |  | LED Indication – Discrete | https://www.digikey.co.uk/product-detail/en/inolux/IN-S63BTG/1830-1069-1-ND/7604713
532 | Green | £0.82 | 5,363 | 3.20 | 100 | 320 | 3.50 | 3.40 | 0.90 | 0.88 | 0.47 | 0.00 | 0.00 | PD1 |  | LED Lighting – Color | https://www.digikey.co.uk/product-detail/en/lumileds/L135-G525003500000/1416-1984-1-ND/6612871
528 | Green | £0.43 | 185 | 3.20 | 20 | 64 | 2.00 | 1.25 | 1.10 | 0.87 | 0.47 | 0.00 | 0.00 | PD1 | LD15 | LED Indication – Discrete | https://www.digikey.co.uk/product-detail/en/inolux/IN-S85ATG/1830-1079-1-ND/7604723
528 | Green | £1.06 | 3,582 | 3.20 | 350 | 1120 | 1.60 | 1.60 | 1.73 | 0.87 | 0.47 | 0.00 | 0.00 | PD1 |  | LED Lighting – Color | https://www.digikey.co.uk/product-detail/en/cree-inc/XQEGRN-00-0000-000000C01/XQEGRN-00-0000-000000C01CT-ND/5806212
527 | Green | £0.83 | 1,036 | 3.00 | 10 | 30 | 3.20 | 2.80 | 2.10 | 0.86 | 0.46 | 0.00 | 0.00 | PD1 |  | LED Indication – Discrete | https://www.digikey.co.uk/product-detail/en/osram-opto-semiconductors-inc/LT-T673-Q2S1-25-26E6-10-R18-Z/475-3770-1-ND/10055051
525 | Green | £0.39 | 140,205 | 2.80 | 5 | 14 | 1.60 | 0.80 | 0.45 | 0.86 | 0.46 | 0.00 | 0.00 | PD1 |  | LED Indication – Discrete | https://www.digikey.co.uk/product-detail/en/lite-on-inc/LTST-C193TGKT-5A/160-1832-1-ND/2356255
525 | Green | £1.21 | 926 | 3.30 | 350 | 1155 | 2.45 | 2.45 | 1.97 | 0.86 | 0.46 | 0.00 | 0.00 | PD1 |  | LED Lighting – Color | https://www.digikey.co.uk/product-detail/en/cree-inc/XBDGRN-00-0000-000000C02/XBDGRN-00-0000-000000C02CT-ND/5766404
524 | Green | £0.32 | 3,240 | 3.00 | 5 | 15 | 1.60 | 0.80 | 0.80 | 0.86 | 0.46 | 0.00 | 0.00 | PD1 |  | LED Indication – Discrete | https://www.digikey.co.uk/product-detail/en/stanley-electric-co/THG1111C-0005-TR/404-1286-1-ND/9477291
523 | Green | £0.82 | 770 | 3.00 | 20 | 60 | 3.20 | 1.60 | 1.40 | 0.85 | 0.46 | 0.00 | 0.00 | PD1 |  | LED Indication – Discrete | https://www.digikey.co.uk/product-detail/en/bivar-inc/SM1206NPGC-IL/492-1945-1-ND/5030121
522 | Green | £1.01 | 98,653 | 3.16 | 150 | 474 | 3.50 | 2.80 | 0.90 | 0.85 | 0.45 | 0.00 | 0.00 | PD1 |  | LED Indication – Discrete | https://www.digikey.co.uk/product-detail/en/broadcom-limited/ASMW-LG00-NY10E/516-4375-1-ND/10257551
521 | Green | £0.94 | 9,000 | 3.40 | 20 | 68 | 3.20 | 1.60 | 1.20 | 0.85 | 0.45 | 0.00 | 0.00 | PD1 |  | LED Indication – Discrete | https://www.digikey.co.uk/product-detail/en/broadcom-limited/HSMQ-C350/516-4366-1-ND/10239793
520 | Green | £0.72 | 8,222 | 3.20 | 20 | 64 | 1.60 | 0.80 | 0.95 | 0.84 | 0.45 | 0.00 | 0.00 | PD1 |  | LED Indication – Discrete | https://www.digikey.co.uk/product-detail/en/sunled/XZM2DG53W-8/1497-1162-1-ND/4745508
519 | Green | £0.57 | 2,500 | 2.90 | 20 | 58 | 2.30 | 2.30 | 3.02 | 0.84 | 0.45 | 0.00 | 0.00 | PD1 |  | LED Indication – Discrete | https://www.digikey.co.uk/product-detail/en/vishay-semiconductor-opto-division/VLDTG1232G-08/VLDTG1232G-08CT-ND/9990308
518 | Green | £0.42 | 5,429 | 2.85 | 20 | 57 | 1.60 | 0.80 | 0.65 | 0.84 | 0.45 | 0.00 | 0.00 | PD1 |  | LED Indication – Discrete | https://www.digikey.co.uk/product-detail/en/vishay-semiconductor-opto-division/VLMTG1400-GS08/VLMTG1400-GS08CT-ND/7597662
517 | Green | £0.28 | 1,324 | 3.00 | 20 | 60 | 3.20 | 2.80 | 2.10 | 0.83 | 0.44 | 0.00 | 0.00 | PD1 |  | LED Indication – Discrete | https://www.digikey.co.uk/product-detail/en/w%C3%BCrth-elektronik/150141GS73113/732-13436-1-ND/9858014
516 | Green | £0.87 | 8,715 | 3.30 | 20 | 66 | 1.00 | 0.50 | 0.50 | 0.83 | 0.44 | 0.00 | 0.00 | PD1 |  | LED Indication – Discrete | https://www.digikey.co.uk/product-detail/en/broadcom-limited/HSMQ-C280/516-3991-1-ND/8537299
515 | Green | £0.55 | 9,335 | 3.30 | 20 | 66 | 2.00 | 1.25 | 1.20 | 0.83 | 0.44 | 0.00 | 0.00 | PD1 |  | LED Indication – Discrete | https://www.digikey.co.uk/product-detail/en/sunled/XZDGK54W-8/1497-1435-1-ND/8259112
505 | Green | £2.28 | 3,298 | 3.25 | 350 | 1137.5 | 3.00 | 3.00 | 1.82 | 0.80 | 0.42 | 0.00 | 0.00 | PD1 |  | LED Lighting – Color | https://www.digikey.co.uk/product-detail/en/osram-opto-semiconductors-inc/LV-CQBP-JZLX-BD-1-350-R18-Z/475-3450-1-ND/7908073
500 | Green | £2.09 | 107 | 2.85 | 500 | 1425 | 1.70 | 1.30 | 0.66 | 0.78 | 0.41 | 0.00 | 0.00 | PD1 |  | LED Lighting – Color | https://www.digikey.co.uk/product-detail/en/lumileds/LXZ1-PE01/1416-1054-1-ND/3961159
476 | Cyan | £0.56 | 40 | 3.10 | 10 | 31 | 3.20 | 2.80 | 2.10 | 0.62 | 0.35 | 0.00 | 0.00 | PD1 |  | LED Indication – Discrete | https://www.digikey.co.uk/product-detail/en/stanley-electric-co/VCEB1104LS-TR/404-1293-1-ND/9477298
475 | Cyan | £0.72 | 4,642 | 3.00 | 100 | 300 | 3.50 | 3.40 | 0.90 | 0.62 | 0.35 | 0.00 | 0.00 | PD1 |  | LED Lighting – Color | https://www.digikey.co.uk/product-detail/en/lumileds/L135-B475003500000/1416-1973-1-ND/6235335
473 | Blue | £0.31 | 1,905 | 3.00 | 5 | 15 | 2.00 | 1.25 | 1.10 | 0.60 | 0.35 | 0.00 | 0.00 | PD1 |  | LED Indication – Discrete | https://www.digikey.co.uk/product-detail/en/inolux/IN-S85AT5B/1830-1078-1-ND/7604720
473 | Blue | £1.10 | 2,012 | 3.10 | 350 | 1085 | 1.60 | 1.60 | 1.73 | 0.60 | 0.35 | 0.00 | 0.00 | PD1 |  | LED Lighting – Color | https://www.digikey.co.uk/product-detail/en/cree-inc/XQEBLU-00-0000-000000Z02/XQEBLU-00-0000-000000Z02CT-ND/5806211
472 | Blue | £0.38 | 1,975 | 3.20 | 20 | 64 | 3.20 | 1.50 | 1.10 | 0.60 | 0.34 | 0.00 | 0.00 | PD1 |  | LED Indication – Discrete | https://www.digikey.co.uk/product-detail/en/inolux/IN-S126ATB/1830-1088-1-ND/7604680
470 | Blue | £0.40 | 19,975 | 3.30 | 20 | 66 | 3.00 | 2.00 | 1.50 | 0.58 | 0.34 | 0.00 | 0.00 | PD1 | LD16 | LED Indication – Discrete | https://www.digikey.co.uk/product-detail/en/american-bright-optoelectronics-corporation/BL-HB332Y/BL-HB332YCT-ND/9678305
470 | Blue | £2.09 | 6,866 | 2.85 | 500 | 1425 | 1.70 | 1.30 | 0.66 | 0.58 | 0.34 | 0.00 | 0.00 | PD1 |  | LED Lighting – Color | https://www.digikey.co.uk/product-detail/en/lumileds/LXZ1-PB01/1416-1052-1-ND/3961157
469 | Blue | £0.35 | 2,505 | 3.00 | 20 | 60 | 2.00 | 1.25 | 0.90 | 0.58 | 0.34 | 0.00 | 0.00 | PD1 |  | LED Indication – Discrete | https://www.digikey.co.uk/product-detail/en/visual-communications-company-vcc/LSM0805463V/28-LSM0805463VCT-ND/10229620
468 | Blue | £0.77 | 8,611 | 3.10 | 20 | 62 | 3.20 | 1.60 | 1.40 | 0.57 | 0.33 | 0.00 | 0.00 | PD1 |  | LED Indication – Discrete | https://www.digikey.co.uk/product-detail/en/bivar-inc/SM1206NBWC-IL/492-1943-1-ND/5030119
467 | Blue | £0.34 | 3,950 | 2.90 | 5 | 14.5 | 1.00 | 0.50 | 0.50 | 0.56 | 0.33 | 0.00 | 0.00 | PD1 |  | LED Indication – Discrete | https://www.digikey.co.uk/product-detail/en/inolux/IN-S42BT5B/1830-IN-S42BT5BCT-ND/10384815
465 | Blue | £0.50 | 4,228 | 3.30 | 20 | 66 | 2.00 | 1.25 | 1.20 | 0.55 | 0.33 | 0.00 | 0.00 | PD1 |  | LED Indication – Discrete | https://www.digikey.co.uk/product-detail/en/sunled/XZFBB54W-8/1497-1437-1-ND/8259114
465 | Blue | £0.34 | 14,288 | 3.40 | 150 | 510 | 3.50 | 3.50 | 1.40 | 0.55 | 0.33 | 0.00 | 0.00 | PD1 |  | LED Lighting – Color | https://www.digikey.co.uk/product-detail/en/tt-electronics-optek-technology/OVS5MBBCR4/365-1544-1-ND/2164125
464 | Blue | £0.67 | 6,401 | 3.20 | 10 | 32 | 3.00 | 2.80 | 1.85 | 0.54 | 0.32 | 0.00 | 0.00 | PD1 |  | LED Indication – Discrete | https://www.digikey.co.uk/product-detail/en/vishay-semiconductor-opto-division/VLMB41P1Q2-GS08/VLMB41P1Q2-GS08CT-ND/4895906
463 | Blue | £0.46 | 1,217 | 3.30 | 20 | 66 | 1.60 | 0.80 | 0.80 | 0.54 | 0.32 | 0.00 | 0.00 | PD1 |  | LED Indication – Discrete | https://www.digikey.co.uk/product-detail/en/stanley-electric-co/VCKB1111CS-TR/404-1299-1-ND/9477304
462 | Blue | £0.71 | 15,997 | 3.40 | 20 | 68 | 2.00 | 1.25 | 0.90 | 0.53 | 0.32 | 0.00 | 0.00 | PD1 |  | LED Indication – Discrete | https://www.digikey.co.uk/product-detail/en/broadcom-limited/HSMR-C170-R0000/516-HSMR-C170-R0000CT-ND/10511779
461 | Blue | £0.70 | 1,487 | 3.30 | 20 | 66 | 1.60 | 0.80 | 0.75 | 0.52 | 0.32 | 0.00 | 0.00 | PD1 |  | LED Indication – Discrete | https://www.digikey.co.uk/product-detail/en/kingbright/APT1608QBC-G/754-1501-1-ND/2263587
460 | Blue | £0.48 | 2,617 | 3.30 | 20 | 66 | 2.00 | 1.25 | 1.20 | 0.52 | 0.31 | 0.00 | 0.00 | PD1 |  | LED Indication – Discrete | https://www.digikey.co.uk/product-detail/en/sunled/XZCBD54W-8/1497-1436-1-ND/8259113
460 | Blue | £2.61 | 706 | 3.20 | 350 | 1120 | 3.30 | 3.30 | 2.15 | 0.52 | 0.31 | 0.00 | 0.00 | PD1 |  | LED Lighting – Color | https://www.digikey.co.uk/product-detail/en/w%C3%BCrth-elektronik/150353BS74500/732-10349-1-ND/6140862
459 | Blue | £0.74 | 18,179 | 3.05 | 20 | 61 | 2.00 | 1.80 | 1.40 | 0.51 | 0.31 | 0.00 | 0.00 | PD1 |  | LED Lighting – Color | https://www.digikey.co.uk/product-detail/en/osram-opto-semiconductors-inc/LD-MVSG-JGLH-46-1/475-3410-1-ND/7908017
458 | Blue | £1.06 | 2,191 | 3.10 | 350 | 1085 | 1.60 | 1.60 | 1.73 | 0.50 | 0.31 | 0.00 | 0.00 | PD1 |  | LED Lighting – Color | https://www.digikey.co.uk/product-detail/en/cree-inc/XQEROY-00-0000-000000L01/XQEROY-00-0000-000000L01CT-ND/5806221
455 | Blue | £2.59 | 611 | 3.30 | 350 | 1155 | 3.45 | 3.45 | 2.20 | 0.48 | 0.30 | 0.00 | 0.00 | PD1 |  | LED Indication – Discrete | https://www.digikey.co.uk/product-detail/en/sunled/XZCB14X160S/1497-1348-1-ND/6615780
455 | Blue | £1.60 | 3,140 | 2.85 | 350 | 997.5 | 3.00 | 3.00 | 1.54 | 0.48 | 0.30 | 0.00 | 0.00 | PD1 |  | LED Lighting – Color | https://www.digikey.co.uk/product-detail/en/osram-opto-semiconductors-inc/GD-CSHPM1-14-UOVJ-W4-1/475-3272-1-ND/6599061
452 | Blue | £0.45 | 715 | 3.00 | 20 | 60 | 2.00 | 1.40 | 1.31 | 0.46 | 0.29 | 0.00 | 0.00 | PD1 |  | LED Indication – Discrete | https://www.digikey.co.uk/product-detail/en/w%C3%BCrth-elektronik/150224BS73100/732-11397-1-ND/7316002
451 | Blue | £0.76 | 15,460 | 3.08 | 150 | 462 | 3.50 | 2.80 | 0.90 | 0.46 | 0.29 | 0.00 | 0.00 | PD1 |  | LED Indication – Discrete | https://www.digikey.co.uk/product-detail/en/broadcom-limited/ASMW-LM00-NGJ0E/516-4342-1-ND/10239769
450 | Blue | £4.70 | 597 | 3.00 | 1000 | 3000 | 3.00 | 3.00 | 0.08 | 0.45 | 0.29 | 0.00 | 0.00 | PD1 |  | LED Indication – Discrete | https://www.digikey.co.uk/product-detail/en/osram-opto-semiconductors-inc/KB-CSLNM1-14-3V6A-46-0-S/475-3718-1-ND/10055001
450 | Blue | £2.07 | 3,059 | 2.85 | 500 | 1425 | 1.70 | 1.30 | 0.66 | 0.45 | 0.29 | 0.00 | 0.00 | PD1 |  | LED Lighting – Color | https://www.digikey.co.uk/product-detail/en/lumileds/LXZ1-PR01/1416-1058-1-ND/3961163
448 | Violet | £0.69 | 9,213 | 3.05 | 100 | 305 | 3.50 | 3.40 | 0.90 | 0.44 | 0.29 | 0.00 | 0.00 | PD1 |  | LED Lighting – Color | https://www.digikey.co.uk/product-detail/en/lumileds/L135-U450003500000/1416-1723-1-ND/5823508
445 | Violet | £1.16 | 1,296 | 3.50 | 150 | 525 | 3.50 | 2.80 | 1.05 | 0.42 | 0.28 | 0.00 | 0.00 | PD1 |  | LED Indication – Discrete | https://www.digikey.co.uk/product-detail/en/sunled/XZCB25X109FS/1497-1309-1-ND/6615689
430 | Violet | £4.95 | 965 | 3.40 | 700 | 2380 | 3.45 | 3.45 | 2.13 | 0.32 | 0.24 | 0.00 | 0.00 | PD1 |  | Infrared, UV, Visible Emitters | https://www.digikey.co.uk/product-detail/en/lite-on-inc/LTPL-C034UVH430/160-2206-1-ND/7364838
430 | Violet | £0.63 | 1,416 | 3.80 | 20 | 76 | 1.60 | 0.80 | 0.80 | 0.32 | 0.24 | 0.00 | 0.00 | PD1 |  | LED Indication – Discrete | https://www.digikey.co.uk/product-detail/en/everlight-electronics-co-ltd/QTLP600CBTR/1080-1401-1-ND/2676135
428 | Violet | £0.99 | 11,241 | 3.90 | 10 | 39 | 1.60 | 0.80 | 0.65 | 0.30 | 0.24 | 0.00 | 0.00 | PD1 |  | LED Indication – Discrete | https://www.digikey.co.uk/product-detail/en/vishay-semiconductor-opto-division/TLMB1100-GS08/751-1156-1-ND/1681439

Sheet: Colors
Wavelength |  | Color
Min | Max
0 | 380 | UV
380 | 450 | Violet
450 | 475 | Blue
475 | 495 | Cyan
495 | 570 | Green
570 | 590 | Yellow
590 | 620 | Orange
620 | 750 | Red
750 | 1400 | NIR
1400 | 3000 | SWIR
3000 | 8000 | MWIR
8000 | 15000 | LWIR
15000 | 1000000 | FIR

Sheet: Photodiode
Wavelength | Intensity
 | PD1 | PD2 | PD3 | PD4
400 | 0.12 | 0.17 | 0.00 | 0.00
500 | 0.78 | 0.41 | 0.00 | 0.00
570 | 1.00 | 0.55 | 0.00 | 0.00
600 | 0.96 | 0.63 | 0.00 | 0.00
700 | 0.45 | 0.76 | 0.11 | 0.08
800 | 0.22 | 0.99 | 0.83 | 0.14
820 | 0.18 | 1.00 | 0.87 | 0.15
900 | 0.11 | 0.83 | 0.96 | 0.35
940 | 0.08 | 0.65 | 1.00 | 0.42
1000 | 0.06 | 0.37 | 0.92 | 0.65
1100 | 0.03 | 0.04 | 0.16 | 0.71
1200 | 0.00 | 0.00 | 0.00 | 0.80
1300 | 0.00 | 0.00 | 0.00 | 0.86
1400 | 0.00 | 0.00 | 0.00 | 0.92
1500 | 0.00 | 0.00 | 0.00 | 0.95
1560 | 0.00 | 0.00 | 0.00 | 0.96
1600 | 0.00 | 0.00 | 0.00 | 0.95
1700 | 0.00 | 0.00 | 0.00 | 0.50
1800 | 0.00 | 0.00 | 0.00 | 0.00
