CodethinkLabs/bloodlight-hardware/hardware/case/codethink-logo-def.scad

/* This variable sets the scale of the logo, bare in mind
 * that the size of this has to be selected by comparison
 * with an object of the desired size.
 */
CT_LOGO_SCALE = 0.10;

module codethink() {
    scale(CT_LOGO_SCALE){
        translate([-283.46457, 60.738585]) {
            g8();
        }
    }
}


// Group ID: g8
module g8() {
	// Path ID: path2
	difference() {
		bezier_polygon([[[196.05983634380001, -3.1370078113], [196.05983634380001, -3.1370078113], [196.05983634380001, -79.91495814870001], [196.05983634380001, -79.91495814870001]], [[196.05983634380001, -79.91495814870001], [196.05983634380001, -79.91495814870001], [196.05196232830002, -79.91495814870001], [196.05196232830002, -79.91495814870001]], [[196.05196232830002, -79.91495814870001], [196.02046626630002, -99.31180793140001], [180.30393132830002, -115.03779168800001], [160.90078233320003, -115.07558696240001]], [[160.90078233320003, -115.07558696240001], [153.1055069882, -115.06298853760002], [145.94802689870002, -112.47401224120001], [140.12597983800003, -108.17165017200001]], [[140.12597983800003, -108.17165017200001], [141.57479869000002, -106.6141699061], [142.94172778080002, -104.96850066660001], [144.14172774300002, -103.20314639150001]], [[144.14172774300002, -103.20314639150001], [148.8692866492, -106.62204392160002], [154.6346407983, -108.67873677020002], [160.90078233320003, -108.67873677020002]], [[160.90078233320003, -108.67873677020002], [176.7417267161, -108.67086275470002], [189.65511213610003, -95.76062694090001], [189.66298615160002, -79.91023373940001]], [[189.66298615160002, -79.91023373940001], [189.66298615160002, -79.91023373940001], [189.66771056090002, -79.91023373940001], [189.66771056090002, -79.91023373940001]], [[189.66771056090002, -79.91023373940001], [189.66771056090002, -79.91023373940001], [189.66771056090002, -3.1370078113], [189.66771056090002, -3.1370078113]], [[189.66771056090002, -3.1370078113], [189.66771056090002, -3.1370078113], [183.2740099749, -3.1370078113], [183.2740099749, -3.1370078113]], [[183.2740099749, -3.1370078113], [183.2740099749, -3.1370078113], [183.2740099749, -79.9102337394], [183.2740099749, -79.9102337394]], [[183.2740099749, -79.9102337394], [183.25196273150002, -92.19527272250001], [173.181096907, -102.26928815320001], [160.8992075301, -102.2960598059]], [[160.8992075301, -102.2960598059], [155.7763730458, -102.2850361842], [151.1259794915, -100.4125952983], [147.35275126390002, -97.4677135013]], [[147.35275126390002, -97.4677135013], [148.2881843053, -95.45826474569999], [149.0755858553, -93.37952465369999], [149.6897590643, -91.21417039119999]], [[149.6897590643, -91.21417039119999], [152.58897157139998, -94.09133565489999], [156.5574753834, -95.88976079509999], [160.8992075301, -95.90235921989998]], [[160.8992075301, -95.90235921989998], [169.622041901, -95.88188677959998], [176.866136161, -88.64251692889998], [176.87086057029998, -79.91653295179998]], [[176.87086057029998, -79.91653295179998], [176.87086057029998, -79.91653295179998], [176.87086057029998, -3.1370078113], [176.87086057029998, -3.1370078113]], [[176.87086057029998, -3.1370078113], [176.87086057029998, -3.1370078113], [170.48660880289998, -3.1370078113], [170.48660880289998, -3.1370078113]], [[170.48660880289998, -3.1370078113], [170.48660880289998, -3.1370078113], [170.48660880289998, -39.5291326492], [170.48660880289998, -39.5291326492]], [[170.48660880289998, -39.5291326492], [167.41574275789998, -38.7921247984], [164.20786884319998, -38.373227173800004], [160.9039319394, -38.3653531583]], [[160.9039319394, -38.3653531583], [151.2110188589, -38.390550007899996], [142.3354285873, -41.7133845489], [135.291334321, -47.25826626400001]], [[135.291334321, -47.25826626400001], [128.2472400547, -41.7291325799], [119.42046867919998, -38.38897520480001], [109.7622012669, -38.362203552100006]], [[109.7622012669, -38.362203552100006], [86.79527285649999, -38.4251956761], [68.2566907633, -56.951179344500005], [68.1905490331, -79.91023373940001]], [[68.1905490331, -79.91023373940001], [68.1984230486, -83.21732024940002], [68.6346435073, -86.42046975480001], [69.3685017519, -89.50078461840002]], [[69.3685017519, -89.50078461840002], [69.3685017519, -89.50078461840002], [60.7480295825, -89.50078461840002], [60.7480295825, -89.50078461840002]], [[60.7480295825, -89.50078461840002], [53.0677148638, -89.50078461840002], [45.93543162390001, -86.26928865720002], [40.55747903740001, -80.84409197770002]], [[40.55747903740001, -80.84409197770002], [35.206298103600005, -75.41417088890002], [31.959054111400008, -68.07873804910002], [31.97637694550001, -60.30550994750001]], [[31.97637694550001, -60.30550994750001], [32.00314859820001, -44.655116739700006], [44.656691506700014, -31.993699815700015], [60.31338392690001, -31.968502966100015]], [[60.31338392690001, -31.968502966100015], [68.1700765928, -31.976376981600016], [75.13858031030001, -35.10866034750001], [80.32440691860002, -40.23936884730001]], [[80.32440691860002, -40.23936884730001], [80.32440691860002, -40.23936884730001], [84.8330681939, -35.714959541], [84.8330681939, -35.714959541]], [[84.8330681939, -35.714959541], [78.5228321722, -29.4346447782], [69.9149584276, -25.577951986299997], [60.314958729999994, -25.577951986299997]], [[60.314958729999994, -25.577951986299997], [41.135431775099995, -25.6125976545], [25.615747224599996, -41.1307074019], [25.5811015564, -60.3055099475]], [[25.5811015564, -60.3055099475], [25.5685031316, -69.8614151583], [29.5527549746, -78.7779503105], [36.012597290799995, -85.33858002510001]], [[36.012597290799995, -85.33858002510001], [42.492912047299995, -91.88188690560001], [51.245667677099995, -95.8929104013], [60.7496043856, -95.88346158270001]], [[60.7496043856, -95.88346158270001], [60.7496043856, -95.88346158270001], [71.417320585, -95.8897607951], [71.417320585, -95.8897607951]], [[71.417320585, -95.8897607951], [72.3527536264, -98.1322804095], [73.5007850863, -100.2629890038], [74.79999764380001, -102.2866109873]], [[74.79999764380001, -102.2866109873], [74.79999764380001, -102.2866109873], [60.7480295825, -102.2866109873], [60.7480295825, -102.2866109873]], [[60.7480295825, -102.2866109873], [38.102361004500004, -102.2409416974], [19.2251962448, -82.99999742160001], [19.1858261673, -60.3070847506]], [[19.1858261673, -60.3070847506], [19.2251962448, -37.6015736548], [37.5999988156, -19.2251962809], [60.3133839269, -19.1905506127]], [[60.3133839269, -19.1905506127], [71.6598402624, -19.1905506127], [81.905509231, -23.7669284213], [89.3496034847, -31.195274644000005]], [[89.3496034847, -31.195274644000005], [89.3496034847, -31.195274644000005], [91.6078711301, -28.930707786200006], [91.6078711301, -28.930707786200006]], [[91.6078711301, -28.930707786200006], [91.6078711301, -28.930707786200006], [93.87086318479999, -26.669290534600005], [93.87086318479999, -26.669290534600005]], [[93.87086318479999, -26.669290534600005], [93.87086318479999, -26.669290534600005], [93.86298916930001, -26.669290534600005], [93.86298916930001, -26.669290534600005]], [[93.86298916930001, -26.669290534600005], [85.2771626681, -18.0992120644], [73.3999976879, -12.7921256174], [60.314958729999994, -12.7921256174]], [[60.314958729999994, -12.7921256174], [34.0661406592, -12.7921256174], [12.7984247937, -34.0645658922], [12.7905507782, -60.3070847506]], [[12.7905507782, -60.3070847506], [12.829920855700001, -86.5622020338], [34.422046159800004, -108.6299178741], [60.7511791887, -108.6771619671]], [[60.7511791887, -108.6771619671], [60.7511791887, -108.6771619671], [79.8440919731, -108.6771619671], [79.8440919731, -108.6771619671]], [[79.8440919731, -108.6771619671], [82.19527300140001, -111.11968157520002], [84.8440918156, -113.2598389881], [87.7259814886, -115.07401215930001]], [[87.7259814886, -115.07401215930001], [87.7259814886, -115.07401215930001], [60.7464547794, -115.07401215930001], [60.7464547794, -115.07401215930001]], [[60.7464547794, -115.07401215930001], [30.7307076934, -114.9480279113], [6.494487984399999, -90.12598144910001], [6.3968501922000005, -60.30865955369999]], [[6.3968501922000005, -60.30865955369999], [6.4062990108, -30.529132932699998], [30.5338573059, -6.3999998345], [60.3118091238, -6.3999998345]], [[60.3118091238, -6.3999998345], [75.1370055072, -6.392125818999999], [88.6582649238, -12.423621692000001], [98.3763748539, -22.129133197300003]], [[98.3763748539, -22.129133197300003], [98.3763748539, -22.129133197300003], [98.38582367250001, -22.140156819], [98.38582367250001, -22.140156819]], [[98.38582367250001, -22.140156819], [98.38582367250001, -22.140156819], [102.897634554, -17.617322315800003], [102.897634554, -17.617322315800003]], [[102.897634554, -17.617322315800003], [102.897634554, -17.617322315800003], [102.88976053850001, -17.6078734972], [102.88976053850001, -17.6078734972]], [[102.88976053850001, -17.6078734972], [92.0362175733, -6.7559053351000005], [76.881887342, 0.00787397940000023], [60.3118091238, -0.0015748391999999]], [[60.3118091238, -0.0015748391999999], [26.987400724700002, -0.011023657799999587], [0.0173228341, -26.9952747763], [0.0, -60.3055099475]], [[0.0, -60.3055099475], [0.1763779472, -93.683461652], [27.044093636299998, -121.2472403113], [60.7464547794, -121.46456313910002]], [[60.7464547794, -121.46456313910002], [60.7464547794, -121.46456313910002], [109.5984217445, -121.46456313910002], [109.5984217445, -121.46456313910002]], [[109.5984217445, -121.46456313910002], [109.5984217445, -121.46456313910002], [109.7622012669, -121.47401195770001], [109.7622012669, -121.47401195770001]], [[109.5984217445, -121.46456313910002], [109.5984217445, -121.46456313910002], [109.7622012669, -121.47401195770001], [109.7622012669, -121.47401195770001]], [[109.7622012669, -121.47401195770001], [109.7622012669, -121.47401195770001], [109.7527524483, -121.47401195770001], [109.7527524483, -121.47401195770001]], [[109.7527524483, -121.47401195770001], [119.4251930885, -121.44724030500002], [128.283460526, -118.11810655160002], [135.3259799892, -112.59212247370002]], [[135.3259799892, -112.59212247370002], [142.37322386169998, -118.12283096090002], [151.2362157085, -121.44724030500002], [160.9023571363, -121.46928754840002]], [[160.9023571363, -121.46928754840002], [183.86141153120002, -121.40472062130002], [202.3905448058, -102.87716214980001], [202.4425133081, -79.91023373940001]], [[202.4425133081, -79.91023373940001], [202.4425133081, -79.91023373940001], [202.4551117329, -79.91023373940001], [202.4551117329, -79.91023373940001]], [[202.4551117329, -79.91023373940001], [202.4551117329, -79.91023373940001], [202.4551117329, -3.1370078113], [202.4551117329, -3.1370078113]], [[202.4551117329, -3.1370078113], [202.4551117329, -3.1370078113], [196.05983634380001, -3.1370078113], [196.05983634380001, -3.1370078113]], [[196.05983634380001, -3.1370078113], [196.05983634380001, -3.1370078113], [196.05983634380001, -3.1370078113], [196.05983634380001, -3.1370078113]]]);
		bezier_polygon([[[160.9023571363, -89.50550902770001], [155.72597934659998, -89.49606020910001], [151.31023145420002, -85.08346192290001], [151.30550704490003, -79.91023373940001]], [[151.30550704490003, -79.91023373940001], [151.31023145420002, -74.74960398070002], [155.7259793466, -70.3385804976], [160.9023571363, -70.31810805730001]], [[160.9023571363, -70.31810805730001], [166.0614120919, -70.3385804976], [170.4771599843, -74.74802917760002], [170.4771599843, -79.91023373940001]], [[170.4771599843, -79.91023373940001], [170.4771599843, -79.91023373940001], [170.48503399979998, -79.91023373940001], [170.48503399979998, -79.91023373940001]], [[170.48503399979998, -79.91023373940001], [170.4771599843, -85.08346192290001], [166.0614120919, -89.49606020910002], [160.9023571363, -89.50550902770001]], [[160.9023571363, -89.50550902770001], [160.9023571363, -89.50550902770001], [160.9023571363, -89.50550902770001], [160.9023571363, -89.50550902770001]], [[160.9023571363, -89.50550902770001], [160.9023571363, -89.50550902770001], [160.9023571363, -89.50550902770001], [160.9023571363, -89.50550902770001]]]);
		bezier_polygon([[[170.4866088029, -46.1354316537], [170.4866088029, -46.1354316537], [170.4866088029, -52.8393684504], [170.4866088029, -52.8393684504]], [[170.4866088029, -52.8393684504], [167.4850340943, -51.75747872070001], [164.2645617548, -51.1543291334], [160.8992075301, -51.1464551179]], [[160.8992075301, -51.1464551179], [145.0503891317, -51.157478739599995], [132.1354289086, -64.0692893565], [132.12283048380002, -79.9118085425]], [[132.12283048380002, -79.9118085425], [132.12283048380002, -79.9118085425], [132.1307044993, -79.9165329518], [132.1307044993, -79.9165329518]], [[132.1307044993, -79.9165329518], [132.1039328466, -92.2062963442], [122.0330670221, -102.27086295630001], [109.7606264638, -102.297634609]], [[109.7606264638, -102.297634609], [109.7606264638, -102.297634609], [109.7606264638, -102.2866109873], [109.7606264638, -102.2866109873]], [[109.7606264638, -102.2866109873], [97.4661386621, -102.27086295630001], [87.3952728376, -92.2062963442], [87.3685011849, -79.919682558]], [[87.3685011849, -79.919682558], [87.3952728376, -67.63779318110001], [97.4661386621, -57.5653525535], [109.7606264638, -57.5338564915]], [[109.7606264638, -57.5338564915], [114.866138114, -57.5527541287], [119.55432694269999, -59.34802966270001], [123.32440556409999, -62.2787382318]], [[123.32440556409999, -62.2787382318], [122.37164968859999, -64.3118090339], [121.57952372929998, -66.42991920340002], [120.96062611099998, -68.6141711031]], [[120.96062611099998, -68.6141711031], [118.05511439149998, -65.74173024870001], [114.09290979189997, -63.94173030540001], [109.7606264638, -63.9307066837]], [[109.7606264638, -63.9307066837], [101.0251936681, -63.951179124], [93.77952460499999, -71.1936985809], [93.76220177089999, -79.9102337394]], [[93.76220177089999, -79.9102337394], [93.77952460499999, -88.6456665351], [101.0251936681, -95.88188677960001], [109.7606264638, -95.90078441680001]], [[109.7606264638, -95.90078441680001], [118.4692876068, -95.88031197650001], [125.7244054885, -88.6456665351], [125.73227950399999, -79.91023373940001]], [[125.73227950399999, -79.91023373940001], [125.73227950399999, -79.91023373940001], [125.7291298978, -79.88503688980002], [125.7291298978, -79.88503688980002]], [[125.7291298978, -79.88503688980002], [125.7905472187, -60.49606112260001], [141.49920814119997, -44.796849018700016], [160.8992075301, -44.74960492570001]], [[160.8992075301, -44.74960492570001], [164.22991608659999, -44.75905374430001], [167.4377900013, -45.25511672080001], [170.48660880289998, -46.13543165370001]], [[170.48660880289998, -46.13543165370001], [170.48660880289998, -46.13543165370001], [170.4866088029, -46.1354316537], [170.4866088029, -46.1354316537]], [[170.4866088029, -46.1354316537], [170.4866088029, -46.1354316537], [170.4866088029, -46.1354316537], [170.4866088029, -46.1354316537]]]);
		bezier_polygon([[[119.3448781304, -79.9102337394], [119.32755529630002, -85.08346192290001], [114.91653181320001, -89.5007846184], [109.76220126690002, -89.5086586339]], [[109.76220126690002, -89.5086586339], [104.5905478865, -89.5007846184], [100.17952440340002, -85.0834619229], [100.16062676620002, -79.9102337394]], [[100.16062676620002, -79.9102337394], [100.17794960030002, -74.7559031931], [104.58897308340002, -70.3385804976], [109.76220126690002, -70.3259820728]], [[109.76220126690002, -70.3259820728], [114.91653181320001, -70.3385804976], [119.32755529630002, -74.7496039807], [119.33700411490001, -79.9102337394]], [[119.33700411490001, -79.9102337394], [119.33700411490001, -79.9102337394], [119.3448781304, -79.9102337394], [119.3448781304, -79.9102337394]], [[119.3448781304, -79.9102337394], [119.3448781304, -79.9102337394], [119.3448781304, -79.9102337394], [119.3448781304, -79.9102337394]]]);
		bezier_polygon([[[109.75275244830001, -115.0803113717], [109.75275244830001, -115.0803113717], [109.76220126690002, -115.07558696240001], [109.76220126690002, -115.07558696240001]], [[109.76220126690002, -115.07558696240001], [90.3543278625, -115.03779168800001], [74.6236196966, -99.31968194689999], [74.58424961909999, -79.9102337394]], [[74.58424961909999, -79.9102337394], [74.6236196966, -60.5118091536], [90.3543278625, -44.7905498063], [109.7622012669, -44.7511797288]], [[109.7622012669, -44.7511797288], [117.543303384, -44.7685025629], [124.71968111070001, -47.341730828299994], [130.5370037621, -51.63779368509999]], [[130.5370037621, -51.63779368509999], [129.0787360915, -53.19527395099999], [127.74645266889998, -54.86928964629999], [126.54330310049998, -56.63621872449999]], [[126.54330310049998, -56.63621872449999], [121.8157441943, -53.20157316339999], [116.0283428018, -51.155903936499996], [109.76220126689998, -51.15117952719999]], [[109.76220126689998, -51.15117952719999], [93.90865845919997, -51.16220314889999], [80.99369823609997, -64.077163372], [80.98109981129998, -79.919682558]], [[80.98109981129998, -79.919682558], [80.99369823609999, -95.76220174400001], [93.90865845919998, -108.67243755780001], [109.76220126689998, -108.6803115733]], [[109.76220126689998, -108.6803115733], [109.76220126689998, -108.6803115733], [109.76220126689998, -108.68661078570001], [109.76220126689998, -108.68661078570001]], [[109.76220126689998, -108.68661078570001], [125.59369683119999, -108.67243755780001], [138.5070822512, -95.76220174400001], [138.5165310698, -79.9165329518]], [[138.5165310698, -79.9165329518], [138.5165310698, -79.9165329518], [138.5165310698, -79.9118085425], [138.5165310698, -79.9118085425]], [[138.5165310698, -79.9118085425], [138.5433027225, -67.6330687718], [148.6094441377, -57.560628144199995], [160.8992075301, -57.543305310099996]], [[160.8992075301, -57.543305310099996], [164.33542789429998, -57.54960452249999], [167.5732230679, -58.363777725199995], [170.48660880289998, -59.76692728729999]], [[170.48660880289998, -59.76692728729999], [170.48660880289998, -59.76692728729999], [170.48660880289998, -67.2803128774], [170.48660880289998, -67.2803128774]], [[170.48660880289998, -67.2803128774], [167.80156951739997, -65.21732081639999], [164.4976326136, -63.938580699199996], [160.8992075301, -63.93070668369999]], [[160.8992075301, -63.93070668369999], [152.1684991437, -63.94645471469999], [144.9307040961, -71.1936985809], [144.90550724649998, -79.9149581487]], [[144.90550724649998, -79.9149581487], [144.90550724649998, -79.9149581487], [144.90865685269998, -79.96535184789998], [144.90865685269998, -79.96535184789998]], [[144.90865685269998, -79.96535184789998], [144.8519639411, -99.3433039934], [129.1385786093, -115.0440909004], [109.7527524483, -115.0803113717]], [[109.7527524483, -115.0803113717], [109.7527524483, -115.0803113717], [109.75275244830001, -115.0803113717], [109.75275244830001, -115.0803113717]], [[109.75275244830001, -115.0803113717], [109.75275244830001, -115.0803113717], [109.75275244830001, -115.0803113717], [109.75275244830001, -115.0803113717]]]);
	}
	difference() {
		bezier_polygon([[[208.393694223, -109.3417288753], [216.4519616857, -117.40944515660001], [227.165347175, -121.47243715460002], [237.70550432330003, -121.47243715460002]], [[237.70550432330003, -121.47243715460002], [237.70550432330003, -121.47243715460002], [325.5984149405, -121.47243715460002], [325.5984149405, -121.47243715460002]], [[325.5984149405, -121.47243715460002], [325.5984149405, -121.47243715460002], [325.5984149405, -70.3259820728], [325.5984149405, -70.3259820728]], [[325.5984149405, -70.3259820728], [325.5984149405, -70.3259820728], [331.9952651327, -70.3259820728], [331.9952651327, -70.3259820728]], [[331.9952651327, -70.3259820728], [331.9952651327, -70.3259820728], [331.9952651327, -121.47401195770001], [331.9952651327, -121.47401195770001]], [[331.9952651327, -121.47401195770001], [331.9952651327, -121.47401195770001], [338.39211532490003, -121.47401195770001], [338.39211532490003, -121.47401195770001]], [[338.39211532490003, -121.47401195770001], [338.39211532490003, -121.47401195770001], [338.39211532490003, -70.3259820728], [338.39211532490003, -70.3259820728]], [[338.39211532490003, -70.3259820728], [338.39211532490003, -70.3259820728], [344.77636709230006, -70.3259820728], [344.77636709230006, -70.3259820728]], [[344.77636709230006, -70.3259820728], [344.77636709230006, -70.3259820728], [344.77636709230006, -121.47401195770001], [344.77636709230006, -121.47401195770001]], [[344.77636709230006, -121.47401195770001], [344.77636709230006, -121.47401195770001], [351.1732172845, -121.47401195770001], [351.1732172845, -121.47401195770001]], [[351.1732172845, -121.47401195770001], [351.1732172845, -121.47401195770001], [351.1732172845, -70.3259820728], [351.1732172845, -70.3259820728]], [[351.1732172845, -70.3259820728], [351.1732172845, -70.3259820728], [355.39683919870004, -70.3259820728], [355.39683919870004, -70.3259820728]], [[355.39683919870004, -70.3259820728], [360.51179966750004, -70.3385804976], [364.8094373274, -74.57165123040001], [364.81731134290004, -79.9181077549]], [[364.81731134290004, -79.9181077549], [364.81731134290004, -79.9181077549], [364.80786252430005, -121.46928754840002], [364.80786252430005, -121.46928754840002]], [[364.80786252430005, -121.46928754840002], [364.80786252430005, -121.46928754840002], [371.20313791340004, -121.46928754840002], [371.20313791340004, -121.46928754840002]], [[371.20313791340004, -121.46928754840002], [371.20313791340004, -121.46928754840002], [371.21101192890006, -79.92440696730002], [371.21101192890006, -79.92440696730002]], [[371.21101192890006, -79.92440696730002], [371.20313791340004, -71.09133637940002], [364.09132711380005, -63.95275392710001], [355.39683919870004, -63.930706683700016]], [[355.39683919870004, -63.930706683700016], [355.39683919870004, -63.930706683700016], [295.07715605940007, -63.930706683700016], [295.07715605940007, -63.930706683700016]], [[295.07715605940007, -63.930706683700016], [295.07715605940007, -63.930706683700016], [295.07715605940007, -79.85826523710001], [295.07715605940007, -79.85826523710001]], [[295.07715605940007, -79.85826523710001], [295.10235290900005, -88.58267441110002], [302.34329756280005, -95.82676867110001], [311.0740059492, -95.84094189900001]], [[311.0740059492, -95.84094189900001], [311.0740059492, -95.84094189900001], [319.21258837000005, -95.84094189900001], [319.21258837000005, -95.84094189900001]], [[319.21258837000005, -95.84094189900001], [319.21258837000005, -95.84094189900001], [319.21258837000005, -102.23464248500002], [319.21258837000005, -102.23464248500002]], [[319.21258837000005, -102.23464248500002], [319.21258837000005, -102.23464248500002], [311.0740059492, -102.23464248500002], [311.0740059492, -102.23464248500002]], [[311.0740059492, -102.23464248500002], [298.7747937382, -102.20787083230003], [288.7133767323, -92.14645382640002], [288.6913294889, -79.85826523710001]], [[288.6913294889, -79.85826523710001], [288.6913294889, -79.85826523710001], [288.6913294889, -57.541730507], [288.6913294889, -57.541730507]], [[288.6913294889, -57.541730507], [288.6913294889, -57.541730507], [355.3952643956, -57.541730507], [355.3952643956, -57.541730507]], [[355.3952643956, -57.541730507], [367.6724293632, -57.5590533411], [377.5999881056, -67.5999979067], [377.5999881056, -79.92755657350001]], [[377.5999881056, -79.92755657350001], [377.5999881056, -79.92755657350001], [377.5999881056, -121.47401195770001], [377.5999881056, -121.47401195770001]], [[377.5999881056, -121.47401195770001], [377.5999881056, -121.47401195770001], [383.9921138885, -121.47401195770001], [383.9921138885, -121.47401195770001]], [[383.9921138885, -121.47401195770001], [383.9921138885, -121.47401195770001], [383.9921138885, -79.92755657350001], [383.9921138885, -79.92755657350001]], [[383.9921138885, -79.92755657350001], [383.96691703889996, -64.1102342371], [371.26455523429996, -51.157478739599995], [355.3968391987, -51.15117952719999]], [[355.3968391987, -51.15117952719999], [355.3968391987, -51.15117952719999], [288.692904292, -51.15117952719999], [288.692904292, -51.15117952719999]], [[288.692904292, -51.15117952719999], [288.692904292, -51.15117952719999], [288.692904292, -3.1370078113], [288.692904292, -3.1370078113]], [[288.692904292, -3.1370078113], [288.692904292, -3.1370078113], [282.299203706, -3.1370078113], [282.299203706, -3.1370078113]], [[282.299203706, -3.1370078113], [282.299203706, -3.1370078113], [282.299203706, -79.85826523710001], [282.299203706, -79.85826523710001]], [[282.299203706, -79.85826523710001], [282.3118021308, -95.70393402930002], [295.2251875508, -108.6157446462], [311.0740059492, -108.628343071]], [[311.0740059492, -108.628343071], [311.0740059492, -108.628343071], [319.21258837, -108.628343071], [319.21258837, -108.628343071]], [[319.21258837, -108.628343071], [319.21258837, -108.628343071], [319.21258837, -115.01889405079999], [319.21258837, -115.01889405079999]], [[319.21258837, -115.01889405079999], [319.21258837, -115.01889405079999], [311.0740059492, -115.01889405079999], [311.0740059492, -115.01889405079999]], [[311.0740059492, -115.01889405079999], [291.6629829386, -114.98267357949999], [275.9448731975, -99.25668982290001], [275.9086527262, -79.85984004020001]], [[275.9086527262, -79.85984004020001], [275.9086527262, -79.85984004020001], [275.9086527262, -3.1370078113], [275.9086527262, -3.1370078113]], [[275.9086527262, -3.1370078113], [275.9086527262, -3.1370078113], [269.51180253399997, -3.1370078113], [269.51180253399997, -3.1370078113]], [[269.51180253399997, -3.1370078113], [269.51180253399997, -3.1370078113], [269.51180253399997, -52.9307070302], [269.51180253399997, -52.9307070302]], [[269.51180253399997, -52.9307070302], [269.51180253399997, -52.9307070302], [267.1480230809, -50.560628364699994], [267.1480230809, -50.560628364699994]], [[267.1480230809, -50.560628364699994], [259.05825955619997, -42.4740144462], [248.3291260359, -38.411022448199994], [237.77007125039998, -38.423620873]], [[237.77007125039998, -38.423620873], [227.21101646489996, -38.411022448199994], [216.47715853529994, -42.456691612099995], [208.39211941989996, -50.560628364699994]], [[208.39211941989996, -50.560628364699994], [208.39211941989996, -50.560628364699994], [208.38896981369996, -50.5637779709], [208.38896981369996, -50.5637779709]], [[208.38896981369996, -50.5637779709], [201.61259207439997, -57.3338564978], [197.69763156779996, -65.96220268270001], [196.59526939779994, -74.7999976799]], [[196.59526939779994, -74.7999976799], [196.37952137309995, -76.51338345270001], [196.23463948789995, -78.234643241], [196.23463948789995, -79.95432822620002]], [[196.23463948789995, -79.95432822620002], [196.22676547239996, -90.51180820860002], [200.28660786419994, -101.2566897599], [208.38424540439993, -109.33070525360002]], [[208.38424540439993, -109.33070525360002], [208.38424540439993, -109.33070525360002], [208.38424540439993, -109.32755564740003], [208.38424540439993, -109.32755564740003]], [[208.38424540439993, -109.32755564740003], [208.38424540439993, -109.32755564740003], [208.393694223, -109.3417288753], [208.393694223, -109.3417288753]]]);
		bezier_polygon([[[212.90550510449995, -104.80787075040001], [206.05983602879994, -97.97322529640002], [202.61889125529993, -88.90550904660002], [202.62834007389992, -79.95432822620002]], [[202.62834007389992, -79.95432822620002], [202.62046605839993, -70.99684819340003], [206.05983602879994, -61.92598233740002], [212.91022951379992, -55.08661247410002]], [[212.91022951379992, -55.08661247410002], [212.91022951379992, -55.08661247410002], [212.90550510449995, -55.08661247410002], [212.90550510449995, -55.08661247410002]], [[212.90550510449995, -55.08661247410002], [219.74172536159995, -48.23621898910002], [228.80786680829996, -44.80787264040002], [237.76692164419995, -44.81732145900002]], [[237.76692164419995, -44.81732145900002], [246.72282687389998, -44.80787264040002], [255.79054312369993, -48.24094339840002], [262.6283381839, -55.08031326170003]], [[262.6283381839, -55.08031326170003], [262.6283381839, -55.08031326170003], [269.417314348, -61.86299021340003], [269.417314348, -61.86299021340003]], [[269.417314348, -61.86299021340003], [269.417314348, -61.86299021340003], [241.77007112439995, -89.51023343700004], [241.77007112439995, -89.51023343700004]], [[241.77007112439995, -89.51023343700004], [241.77007112439995, -89.51023343700004], [237.77164605349998, -89.51023343700004], [237.77164605349998, -89.51023343700004]], [[237.77164605349998, -89.51023343700004], [236.31810279219997, -89.50235942150005], [234.94172488279997, -89.16850116430004], [233.66770917489998, -88.57637519870003]], [[233.66770917489998, -88.57637519870003], [233.66770917489998, -88.57637519870003], [260.3732201447, -61.86299021340003], [260.3732201447, -61.86299021340003]], [[260.3732201447, -61.86299021340003], [260.3732201447, -61.86299021340003], [258.1070784838, -59.60944697730003], [258.1070784838, -59.60944697730003]], [[258.1070784838, -59.60944697730003], [252.51337787260002, -54.00629754750003], [245.1228269243, -51.212596848100034], [237.7669216442, -51.212596848100034]], [[237.7669216442, -51.212596848100034], [230.40314234860003, -51.212596848100034], [223.0125914003, -54.00629754750003], [217.4314892139, -59.60944697730003]], [[217.4314892139, -59.60944697730003], [217.4314892139, -59.60944697730003], [217.4267648046, -59.60944697730003], [217.4267648046, -59.60944697730003]], [[217.4267648046, -59.60944697730003], [211.8283397841, -65.20314758850004], [209.0251902661, -72.59842294610003], [209.0251902661, -79.95590302930005]], [[209.0251902661, -79.95590302930005], [209.0251902661, -87.30235949080004], [211.8283397841, -94.69920965150004], [217.4267648046, -100.29291026270003]], [[217.4267648046, -100.29291026270003], [217.4267648046, -100.29291026270003], [217.4346388201, -100.29763467200003], [217.4346388201, -100.29763467200003]], [[217.4346388201, -100.29763467200003], [217.4346388201, -100.29763467200003], [217.4267648046, -100.29763467200003], [217.4267648046, -100.29763467200003]], [[217.4267648046, -100.29763467200003], [217.4267648046, -100.29763467200003], [217.4314892139, -100.30235908130004], [217.4314892139, -100.30235908130004]], [[217.4314892139, -100.30235908130004], [217.4314892139, -100.30235908130004], [217.4346388201, -100.30550868750002], [217.4346388201, -100.30550868750002]], [[217.4346388201, -100.30550868750002], [223.0283394313, -105.89133528320002], [230.4141659703, -108.69448480120002], [237.7700712504, -108.68503598260003]], [[237.7700712504, -108.68503598260003], [237.7700712504, -108.68503598260003], [281.2267627949, -108.68503598260003], [281.2267627949, -108.68503598260003]], [[281.2267627949, -108.68503598260003], [283.5952666573, -111.14330362170001], [286.2881799583, -113.26456339740002], [289.2031404964, -115.08346097790003]], [[289.2031404964, -115.08346097790003], [289.2031404964, -115.08346097790003], [237.7700712504, -115.08031137170003], [237.7700712504, -115.08031137170003]], [[237.7700712504, -115.08031137170003], [228.81101641450002, -115.09605940270005], [219.7511741802, -111.65826423540003], [212.91337912000003, -104.82361878140003]], [[212.91337912000003, -104.82361878140003], [212.91337912000003, -104.82361878140003], [212.90550510449995, -104.80787075040001], [212.90550510449995, -104.80787075040001]]]);
		bezier_polygon([[[269.51337733710005, -70.78897418420003], [269.51337733710005, -70.78897418420003], [269.51337733710005, -79.85826523710004], [269.51337733710005, -79.85826523710004]], [[269.51337733710005, -79.85826523710004], [269.52597576190004, -83.19054859670004], [269.9700702361, -86.41102093620003], [270.70865289, -89.50865863390004]], [[270.70865289, -89.50865863390004], [270.70865289, -89.50865863390004], [250.7952676905, -89.50865863390004], [250.7952676905, -89.50865863390004]], [[250.7952676905, -89.50865863390004], [250.7952676905, -89.50865863390004], [269.51337733710005, -70.78897418420003], [269.51337733710005, -70.78897418420003]], [[269.51337733710005, -70.78897418420003], [269.51337733710005, -70.78897418420003], [269.51337733710005, -70.78897418420003], [269.51337733710005, -70.78897418420003]]]);
		bezier_polygon([[[237.77164605350004, -102.29920941210004], [232.01574072300002, -102.28818579040002], [226.2944810607, -100.12913074030004], [221.96219773260003, -95.77480016880004]], [[221.96219773260003, -95.77480016880004], [221.96219773260003, -95.77480016880004], [221.95432371710004, -95.77480016880004], [221.95432371710004, -95.77480016880004]], [[221.95432371710004, -95.77480016880004], [221.95432371710004, -95.77480016880004], [221.95432371710004, -95.77165056260003], [221.95432371710004, -95.77165056260003]], [[221.95432371710004, -95.77165056260003], [217.59526873630006, -91.41259558180003], [215.42833967070004, -85.70078473810003], [215.42833967070004, -79.95432822620002]], [[215.42833967070004, -79.95432822620002], [215.42833967070004, -74.19999769880003], [217.59369393320003, -68.48188764270003], [221.95432371710004, -64.12598226810002]], [[221.95432371710004, -64.12598226810002], [221.95432371710004, -64.12598226810002], [221.95432371710004, -64.13070667740003], [221.95432371710004, -64.13070667740003]], [[221.95432371710004, -64.13070667740003], [226.29133145450004, -59.77637610590001], [232.00786670750009, -57.60787223720001], [237.76849644730007, -57.60157302480001]], [[237.76849644730007, -57.60157302480001], [242.50550417210007, -57.60944704030002], [247.22518906280004, -59.083462741900014], [251.17007082830003, -62.02991934200001]], [[251.17007082830003, -62.02991934200001], [251.17007082830003, -62.02991934200001], [229.20314238640003, -84.02991864900001], [229.20314238640003, -84.02991864900001]], [[229.20314238640003, -84.02991864900001], [229.20314238640003, -84.02991864900001], [229.20314238640003, -84.16377691250001], [229.20314238640003, -84.16377691250001]], [[229.20314238640003, -84.16377691250001], [229.20314238640003, -84.16377691250001], [229.14172506550003, -84.0503910893], [229.14172506550003, -84.0503910893]], [[229.14172506550003, -84.0503910893], [228.54487469060007, -82.77795018450001], [228.21889044890003, -81.40314707820002], [228.20629202410004, -79.95432822620002]], [[228.20629202410004, -79.95432822620002], [228.21889044890005, -77.41417082590002], [229.12912664070006, -75.03936775110002], [230.97952028320003, -73.17165127450001]], [[230.97952028320003, -73.17165127450001], [230.97952028320003, -73.17165127450001], [239.95589795320004, -64.23464368200001], [239.95589795320004, -64.23464368200001]], [[239.95589795320004, -64.23464368200001], [239.21731529930003, -64.13543108670001], [238.51022870740002, -64.00314762630002], [237.76692164420004, -64.00314762630002]], [[237.76692164420004, -64.00314762630002], [233.59841783850007, -64.00944683870001], [229.55904788700008, -65.55117907360001], [226.47085900790003, -68.65039157440002]], [[226.47085900790003, -68.65039157440002], [226.47085900790003, -68.65039157440002], [226.47558341720003, -68.65511598370001], [226.47558341720003, -68.65511598370001]], [[226.47558341720003, -68.65511598370001], [226.47558341720003, -68.65511598370001], [226.47085900790003, -68.66141519610001], [226.47085900790003, -68.66141519610001]], [[226.47085900790003, -68.66141519610001], [223.35904808230003, -71.76535210620003], [221.82204025670003, -75.80944646700001], [221.81259143810004, -79.95432822620002]], [[221.81259143810004, -79.95432822620002], [221.82046545360004, -84.10235959160002], [223.35432367300007, -88.13543033070002], [226.47085900790003, -91.24251684700002]], [[226.47085900790003, -91.24251684700002], [226.47085900790003, -91.24251684700002], [226.47873302340003, -91.25983968110002], [226.47873302340003, -91.25983968110002]], [[226.47873302340003, -91.25983968110002], [229.5684967056, -94.35747737880001], [233.61889027880002, -95.89133559820002], [237.77164605350004, -95.90078441680002]], [[237.77164605350004, -95.90078441680002], [237.77164605350004, -95.90078441680002], [272.76534573860005, -95.90078441680002], [272.76534573860005, -95.90078441680002]], [[272.76534573860005, -95.90078441680002], [273.70550318930003, -98.14645363740003], [274.86140866470004, -100.27243782240002], [276.16219602530003, -102.29763460900003]], [[276.16219602530003, -102.29763460900003], [276.16219602530003, -102.29763460900003], [237.77164605350004, -102.29763460900003], [237.77164605350004, -102.29763460900003]], [[237.77164605350004, -102.29763460900003], [237.77164605350004, -102.29763460900003], [237.77164605350004, -102.29920941210004], [237.77164605350004, -102.29920941210004]], [[237.77164605350004, -102.29920941210004], [237.77164605350004, -102.29920941210004], [237.77164605350004, -102.29920941210004], [237.77164605350004, -102.29920941210004]]]);
		bezier_polygon([[[311.0755807523, -89.44094210060004], [305.89920296260004, -89.43464288820005], [301.4929038888, -85.02991861750003], [301.47873066090006, -79.85826523710004]], [[301.47873066090006, -79.85826523710004], [301.47873066090006, -79.85826523710004], [301.47873066090006, -70.32598207280004], [301.47873066090006, -70.32598207280004]], [[301.47873066090006, -70.32598207280004], [301.47873066090006, -70.32598207280004], [319.2141631731, -70.32598207280004], [319.2141631731, -70.32598207280004]], [[319.2141631731, -70.32598207280004], [319.2141631731, -70.32598207280004], [319.2141631731, -89.447241313], [319.2141631731, -89.447241313]], [[319.2141631731, -89.447241313], [319.2141631731, -89.447241313], [311.0755807523, -89.44094210060004], [311.0755807523, -89.44094210060004]], [[311.0755807523, -89.44094210060004], [311.0755807523, -89.44094210060004], [311.0755807523, -89.44094210060004], [311.0755807523, -89.44094210060004]]]);
	}
	bezier_polygon([[[396.7858142729, -100.69448505320003], [396.7858142729, -100.69448505320003], [396.7858142729, -41.21102236], [396.7858142729, -41.21102236]], [[396.7858142729, -41.21102236], [396.7858142729, -41.21102236], [390.3905388838, -41.209447556899995], [390.3905388838, -41.20944755689999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
	bezier_polygon([[[403.17006604029996, -41.21102236], [403.17006604029996, -41.21102236], [403.17006604029996, -41.209447556899995], [403.17006604029996, -41.209447556899995]], [[403.17006604029996, -41.209447556899995], [403.17006604029996, -41.209447556899995], [403.17006604029996, -41.21102236], [403.17006604029996, -41.21102236]]]);
	// Path ID: path4
	bezier_polygon([[[403.17006604029996, -121.47243715460002], [403.17006604029996, -121.47243715460002], [409.5669162325, -121.47243715460002], [409.5669162325, -121.47243715460002]], [[409.5669162325, -121.47243715460002], [409.5669162325, -121.47243715460002], [409.5669162325, -41.2078727538], [409.5669162325, -41.2078727538]], [[409.5669162325, -41.2078727538], [409.5669162325, -41.2078727538], [403.17006604029996, -41.2078727538], [403.17006604029996, -41.2078727538]], [[403.17006604029996, -41.2078727538], [403.17006604029996, -41.2078727538], [403.17006604029996, -41.21102236], [403.17006604029996, -41.21102236]], [[403.17006604029996, -41.21102236], [403.17006604029996, -41.21102236], [403.17006604029996, -121.47243715460002], [403.17006604029996, -121.47243715460002]], [[403.17006604029996, -121.47243715460002], [403.17006604029996, -121.47243715460002], [403.17006604029996, -121.47243715460002], [403.17006604029996, -121.47243715460002]]]);
	difference() {
		bezier_polygon([[[406.5306958557, -3.6099995881500035e-08], [395.9401450082, -0.026771688799995363], [387.4157358279, -8.562204490799996], [387.40313740309995, -19.141731716599995]], [[387.40313740309995, -19.141731716599995], [387.4157358279, -29.710235320699997], [395.9401450082, -38.255116941299995], [406.5306958557, -38.27086497229999]], [[406.5306958557, -38.27086497229999], [417.11967190009995, -38.26141615369999], [425.6535298989999, -29.680314061799997], [425.6535298989999, -19.141731716599995]], [[425.6535298989999, -19.141731716599995], [425.6535298989999, -8.590550946599993], [417.11967190009995, -0.011023657799995146], [406.5306958556999, -3.6099995881500035e-08]], [[406.5306958556999, -3.6099995881500035e-08], [406.5306958556999, -3.6099995881500035e-08], [406.5306958557, -3.6099995881500035e-08], [406.5306958557, -3.6099995881500035e-08]], [[406.5306958557, -3.6099995881500035e-08], [406.5306958557, -3.6099995881500035e-08], [406.5306958557, -3.6099995881500035e-08], [406.5306958557, -3.6099995881500035e-08]]]);
		bezier_polygon([[[406.5306958557, -31.872439976999996], [399.4818771801, -31.862991158399996], [393.8015623984, -26.1748023612], [393.79683798909997, -19.1338577011]], [[393.79683798909997, -19.1338577011], [393.80156239839994, -12.097637450299995], [399.4818771801, -6.406299046899995], [406.5306958557, -6.399999834499996]], [[406.5306958557, -6.399999834499996], [413.5795145313, -6.399999834499996], [419.2692781316, -12.113385481299996], [419.2692781316, -19.1338577011]], [[419.2692781316, -19.1338577011], [419.2692781316, -26.155904724], [413.5795145313, -31.872439976999996], [406.5306958557, -31.872439976999996]], [[406.5306958557, -31.872439976999996], [406.5306958557, -31.872439976999996], [406.5306958557, -31.872439976999996], [406.5306958557, -31.872439976999996]], [[406.5306958557, -31.872439976999996], [406.5306958557, -31.872439976999996], [406.5306958557, -31.872439976999996], [406.5306958557, -31.872439976999996]]]);
	}
	bezier_polygon([[[406.5306958557, -12.795275223599997], [403.02045974579994, -12.795275223599997], [400.1984125906, -15.628346000499995], [400.1984125906, -19.138582110399994]], [[400.1984125906, -19.138582110399994], [400.1984125906, -22.640944204799997], [403.0188849427, -25.48188899719999], [406.5306958557, -25.48188899719999]], [[406.5306958557, -25.48188899719999], [410.04250676870004, -25.48188899719999], [412.8740027425, -22.639369401699994], [412.8740027425, -19.138582110399994]], [[412.8740027425, -19.138582110399994], [412.8755775456, -15.639369622199997], [410.04250676870004, -12.795275223599997], [406.5306958557, -12.795275223599997]], [[406.5306958557, -12.795275223599997], [406.5306958557, -12.795275223599997], [406.5306958557, -12.795275223599997], [406.5306958557, -12.795275223599997]], [[406.5306958557, -12.795275223599997], [406.5306958557, -12.795275223599997], [406.5306958557, -12.795275223599997], [406.5306958557, -12.795275223599997]]]);
	bezier_polygon([[[473.4913236677, -121.47243715460002], [473.4913236677, -121.47243715460002], [467.1070719003, -121.47243715460002], [467.1070719003, -121.47243715460002]], [[467.1070719003, -121.47243715460002], [467.1070719003, -121.47243715460002], [473.4913236677, -121.47243715460002], [473.4913236677, -121.47243715460002]]]);
	bezier_polygon([[[486.2913232645, -121.47243715460002], [486.2913232645, -121.47243715460002], [479.88817385990006, -121.47243715460002], [479.88817385990006, -121.47243715460002]], [[479.88817385990006, -121.47243715460002], [479.88817385990006, -121.47243715460002], [486.2913232645, -121.47243715460002], [486.2913232645, -121.47243715460002]]]);
	// Path ID: path6
	bezier_polygon([[[473.4913236677, -121.47243715460002], [473.4913236677, -121.47243715460002], [473.4913236677, -79.9102337394], [473.4913236677, -79.9102337394]], [[473.4913236677, -79.9102337394], [473.4818748491, -71.1936985809], [466.22833177049995, -63.944879911600005], [457.5180958244, -63.9370058961]], [[457.5180958244, -63.9370058961], [448.78738743800005, -63.944879911600005], [441.5401435718, -71.1842497623], [441.5291199501, -79.9102337394]], [[441.5291199501, -79.9102337394], [441.5291199501, -79.9102337394], [441.5291199501, -121.47401195770001], [441.5291199501, -121.47401195770001]], [[441.5291199501, -121.47401195770001], [441.5291199501, -121.47401195770001], [447.9259701423, -121.47401195770001], [447.9259701423, -121.47401195770001]], [[447.9259701423, -121.47401195770001], [447.9259701423, -121.47401195770001], [447.9259701423, -79.9181077549], [447.9259701423, -79.9181077549]], [[447.9259701423, -79.9181077549], [447.93069455159997, -74.74960398070002], [452.3369936254, -70.3385804976], [457.5180958244, -70.3259820728]], [[457.5180958244, -70.3259820728], [462.67715078000003, -70.3385804976], [467.0928986724, -74.75432839], [467.1070719003, -79.9181077549]], [[467.1070719003, -79.9181077549], [467.1070719003, -79.9181077549], [467.1070719003, -121.47401195770001], [467.1070719003, -121.47401195770001]], [[467.1070719003, -121.47401195770001], [467.1070719003, -121.47401195770001], [473.4913236677, -121.47401195770001], [473.4913236677, -121.47401195770001]], [[473.4913236677, -121.47401195770001], [473.4913236677, -121.47401195770001], [473.4913236677, -121.47243715460002], [473.4913236677, -121.47243715460002]], [[473.4913236677, -121.47243715460002], [473.4913236677, -121.47243715460002], [473.4913236677, -121.47243715460002], [473.4913236677, -121.47243715460002]]]);
	bezier_polygon([[[457.51337141510004, -57.5322816884], [469.79998520130005, -57.5637777504], [479.8614022072, -67.636218378], [479.88817385990006, -79.9102337394]], [[479.88817385990006, -79.9102337394], [479.88817385990006, -79.9102337394], [479.88817385990006, -121.47401195770001], [479.88817385990006, -121.47401195770001]], [[479.88817385990006, -121.47401195770001], [479.88817385990006, -121.47401195770001], [486.28974846140005, -121.47401195770001], [486.28974846140005, -121.47401195770001]], [[486.28974846140005, -121.47401195770001], [486.28974846140005, -121.47401195770001], [486.2802996428001, -79.91023373940001], [486.2802996428001, -79.91023373940001]], [[486.2802996428001, -79.91023373940001], [486.26140200560013, -64.07558856890002], [473.3495913887001, -51.160628345800006], [457.5117966120001, -51.15275433030001]], [[457.5117966120001, -51.15275433030001], [441.6598286074002, -51.16062834580002], [428.75746680910015, -64.07558856890003], [428.73699436880014, -79.91023373940001]], [[428.73699436880014, -79.91023373940001], [428.73699436880014, -79.91023373940001], [428.73699436880014, -121.47401195770001], [428.73699436880014, -121.47401195770001]], [[428.73699436880014, -121.47401195770001], [428.73699436880014, -121.47401195770001], [435.1417185765002, -121.47401195770001], [435.1417185765002, -121.47401195770001]], [[435.1417185765002, -121.47401195770001], [435.1417185765002, -121.47401195770001], [435.1417185765002, -79.9102337394], [435.1417185765002, -79.9102337394]], [[435.1417185765002, -79.9102337394], [435.16219101680014, -67.63621837800001], [445.22045841650015, -57.562202947299994], [457.5133714151002, -57.5322816884]], [[457.5133714151002, -57.5322816884], [457.5133714151002, -57.5322816884], [457.51337141510004, -57.5322816884], [457.51337141510004, -57.5322816884]], [[457.51337141510004, -57.5322816884], [457.51337141510004, -57.5322816884], [457.51337141510004, -57.5322816884], [457.51337141510004, -57.5322816884]]]);
	bezier_polygon([[[499.0771496334, -3.2047243445999998], [499.0771496334, -3.2047243445999998], [492.68029944119996, -3.196850329099999], [492.68029944119996, -3.196850329099999]], [[492.68029944119996, -3.196850329099999], [492.68029944119996, -3.196850329099999], [492.68029944119996, -57.902360416899995], [492.68029944119996, -57.902360416899995]], [[492.68029944119996, -57.902360416899995], [485.338567389, -46.1999985808], [472.37163866360004, -38.4031484327], [457.5196706275, -38.3622035521]], [[457.5196706275, -38.3622035521], [442.6629781821, -38.4031484327], [429.700773866, -46.1905497622], [422.3590418138, -57.8818879766]], [[422.3590418138, -57.8818879766], [422.3590418138, -57.8818879766], [422.3590418138, -41.209447556899995], [422.3590418138, -41.209447556899995]], [[422.3590418138, -41.209447556899995], [422.3590418138, -41.209447556899995], [415.97006563709994, -41.21102236], [415.97006563709994, -41.21102236]], [[415.97006563709994, -41.21102236], [415.97006563709994, -41.21102236], [415.97006563709994, -79.6787376837], [415.97006563709994, -79.6787376837]], [[415.97006563709994, -79.6787376837], [415.97006563709994, -79.6787376837], [415.95746721229995, -79.9181077549], [415.95746721229995, -79.9181077549]], [[415.95746721229995, -79.9181077549], [415.95746721229995, -79.9181077549], [415.95746721229995, -121.47401195770001], [415.95746721229995, -121.47401195770001]], [[415.95746721229995, -121.47401195770001], [415.95746721229995, -121.47401195770001], [422.3574670107, -121.47401195770001], [422.3574670107, -121.47401195770001]], [[422.3574670107, -121.47401195770001], [422.3574670107, -121.47401195770001], [422.3574670107, -79.83149358440001], [422.3574670107, -79.83149358440001]], [[422.3574670107, -79.83149358440001], [422.42833315020005, -60.477163485400006], [438.1401436789, -44.7874002001], [457.5180958244, -44.751179728800004]], [[457.5180958244, -44.751179728800004], [476.9054967885, -44.7968490187], [492.629905742, -60.5070847443], [492.6740002288, -79.91023373940001]], [[492.6740002288, -79.91023373940001], [492.6740002288, -79.91023373940001], [492.6787246381, -121.47401195770001], [492.6787246381, -121.47401195770001]], [[492.6787246381, -121.47401195770001], [492.6787246381, -121.47401195770001], [499.0755748303, -121.47401195770001], [499.0755748303, -121.47401195770001]], [[499.0755748303, -121.47401195770001], [499.0755748303, -121.47401195770001], [499.0755748303, -3.2047243445999998], [499.0755748303, -3.2047243445999998]], [[499.0755748303, -3.2047243445999998], [499.0755748303, -3.2047243445999998], [499.0771496334, -3.2047243445999998], [499.0771496334, -3.2047243445999998]], [[499.0771496334, -3.2047243445999998], [499.0771496334, -3.2047243445999998], [499.0771496334, -3.2047243445999998], [499.0771496334, -3.2047243445999998]]]);
	bezier_polygon([[[511.85037757749996, -121.46771274529999], [511.85037757749996, -121.46771274529999], [511.85037757749996, -3.2015747383999997], [511.85037757749996, -3.2015747383999997]], [[511.85037757749996, -3.2015747383999997], [511.85037757749996, -3.2015747383999997], [505.4661258101, -3.2015747383999997], [505.4661258101, -3.2015747383999997]], [[505.4661258101, -3.2015747383999997], [505.4661258101, -3.2015747383999997], [505.4661258101, -121.4677127453], [505.4661258101, -121.4677127453]], [[505.4661258101, -121.4677127453], [505.4661258101, -121.4677127453], [511.85037757749996, -121.46771274529999], [511.85037757749996, -121.46771274529999]], [[511.85037757749996, -121.46771274529999], [511.85037757749996, -121.46771274529999], [511.85037757749996, -121.46771274529999], [511.85037757749996, -121.46771274529999]]]);
	bezier_polygon([[[558.0488013191, -79.9149581487], [563.5669113815001, -72.86613947309999], [566.9023443473, -64.00944683869999], [566.929116, -54.34488021399999]], [[566.929116, -54.34488021399999], [566.929116, -54.34488021399999], [566.9196671814001, -41.211022359999994], [566.9196671814001, -41.211022359999994]], [[566.9196671814001, -41.211022359999994], [566.9196671814001, -41.211022359999994], [560.5259665954001, -41.211022359999994], [560.5259665954001, -41.211022359999994]], [[560.5259665954001, -41.211022359999994], [560.5259665954001, -41.211022359999994], [560.5259665954001, -54.349604623299996], [560.5259665954001, -54.349604623299996]], [[560.5259665954001, -54.349604623299996], [560.4944705334001, -73.7480292091], [544.7700615799, -89.4614145409], [525.3795110096, -89.5007846184]], [[525.3795110096, -89.5007846184], [525.3795110096, -89.5007846184], [525.3795110096, -89.5086586339], [525.3795110096, -89.5086586339]], [[525.3795110096, -89.5086586339], [525.3795110096, -89.5086586339], [524.645652765, -89.5086586339], [524.645652765, -89.5086586339]], [[524.645652765, -89.5086586339], [524.645652765, -89.5086586339], [524.645652765, -83.10865883550001], [524.645652765, -83.10865883550001]], [[524.645652765, -83.10865883550001], [524.645652765, -83.10865883550001], [525.3747866003001, -83.10865883550001], [525.3747866003001, -83.10865883550001]], [[525.3747866003001, -83.10865883550001], [525.3747866003001, -83.10865883550001], [525.3747866003001, -83.116532851], [525.3747866003001, -83.116532851]], [[525.3747866003001, -83.116532851], [525.3747866003001, -83.116532851], [525.3795110096, -83.116532851], [525.3795110096, -83.116532851]], [[525.3795110096, -83.116532851], [541.2110065739, -83.0944856076], [554.1291164032001, -70.17952538450001], [554.1432896311001, -54.349604623299996]], [[554.1432896311001, -54.349604623299996], [554.1432896311001, -54.349604623299996], [554.1338408125, -41.21102236], [554.1338408125, -41.21102236]], [[554.1338408125, -41.21102236], [554.1338408125, -41.21102236], [547.7543134544001, -41.21102236], [547.7543134544001, -41.21102236]], [[547.7543134544001, -41.21102236], [547.7543134544001, -41.21102236], [547.748014242, -54.349604623299996], [547.748014242, -54.349604623299996]], [[547.748014242, -54.349604623299996], [547.7228173924, -66.6236199847], [537.6661247958, -76.69133620299999], [525.3795110096, -76.7133834464]], [[525.3795110096, -76.7133834464], [525.3795110096, -76.7133834464], [524.645652765, -76.7133834464], [524.645652765, -76.7133834464]], [[524.645652765, -76.7133834464], [524.645652765, -76.7133834464], [524.645652765, -70.31810805730001], [524.645652765, -70.31810805730001]], [[524.645652765, -70.31810805730001], [524.645652765, -70.31810805730001], [525.3795110096, -70.31810805730001], [525.3795110096, -70.31810805730001]], [[525.3795110096, -70.31810805730001], [534.0913217588, -70.3039348294], [541.338565625, -63.05826576629999], [541.3511640498, -54.3480298202]], [[541.3511640498, -54.3480298202], [541.3511640498, -54.3480298202], [541.3653372777, -41.209447556899995], [541.3653372777, -41.209447556899995]], [[541.3653372777, -41.209447556899995], [541.3653372777, -41.209447556899995], [534.9684870855, -41.209447556899995], [534.9684870855, -41.209447556899995]], [[534.9684870855, -41.209447556899995], [534.9684870855, -41.209447556899995], [534.9684870855, -54.3433054109], [534.9684870855, -54.3433054109]], [[534.9684870855, -54.3433054109], [534.9511642514, -59.4992107603], [530.535416359, -63.92440747129999], [525.3763614034, -63.92913188059999]], [[525.3763614034, -63.92913188059999], [525.3763614034, -63.92913188059999], [524.6472275680999, -63.92913188059999], [524.6472275680999, -63.92913188059999]], [[524.6472275680999, -63.92913188059999], [524.6472275680999, -63.92913188059999], [524.6472275680999, -3.196850329099999], [524.6472275680999, -3.196850329099999]], [[524.6472275680999, -3.196850329099999], [524.6472275680999, -3.196850329099999], [518.2582513913999, -3.2047243445999998], [518.2582513913999, -3.2047243445999998]], [[518.2582513913999, -3.2047243445999998], [518.2582513913999, -3.2047243445999998], [518.2582513913999, -121.4740119577], [518.2582513913999, -121.4740119577]], [[518.2582513913999, -121.4740119577], [518.2582513913999, -121.4740119577], [524.6472275680999, -121.4740119577], [524.6472275680999, -121.4740119577]], [[524.6472275680999, -121.4740119577], [524.6472275680999, -121.4740119577], [524.6472275680999, -95.89133559820002], [524.6472275680999, -95.89133559820002]], [[524.6472275680999, -95.89133559820002], [524.6472275680999, -95.89133559820002], [525.3763614034, -95.89133559820002], [525.3763614034, -95.89133559820002]], [[525.3763614034, -95.89133559820002], [530.5338415558999, -95.90078441680001], [534.9511642514, -100.31968191540001], [534.9684870855, -105.48188647720002]], [[534.9684870855, -105.48188647720002], [534.9684870855, -105.48188647720002], [534.9684870855, -121.47243715460002], [534.9684870855, -121.47243715460002]], [[534.9684870855, -121.47243715460002], [534.9684870855, -121.47243715460002], [541.3527388529, -121.47243715460002], [541.3527388529, -121.47243715460002]], [[541.3527388529, -121.47243715460002], [541.3527388529, -121.47243715460002], [541.3527388529, -105.48188647720002], [541.3527388529, -105.48188647720002]], [[541.3527388529, -105.48188647720002], [541.3495892466999, -101.14172913360001], [539.5448648940999, -97.17480012470001], [536.6692744334999, -94.27558761760001]], [[536.6692744334999, -94.27558761760001], [538.8535263332, -93.65668999930001], [540.9621876841, -92.85983963070001], [542.9921088799999, -91.90393414900001]], [[542.9921088799999, -91.90393414900001], [545.9180930397999, -95.68661119520002], [547.7338410141, -100.3622015991], [547.7495890450999, -105.48188647720002]], [[547.7495890450999, -105.48188647720002], [547.7495890450999, -105.48188647720002], [547.7495890450999, -121.47716156390001], [547.7495890450999, -121.47716156390001]], [[547.7495890450999, -121.47716156390001], [547.7495890450999, -121.47716156390001], [554.1448644341999, -121.47716156390001], [554.1448644341999, -121.47716156390001]], [[554.1448644341999, -121.47716156390001], [554.1448644341999, -121.47716156390001], [554.1448644341999, -121.47243715460002], [554.1448644341999, -121.47243715460002]], [[554.1448644341999, -121.47243715460002], [554.1448644341999, -121.47243715460002], [554.1354156156, -105.48188647720002], [554.1354156156, -105.48188647720002]], [[554.1354156156, -105.48188647720002], [554.1306912063, -99.22204415470003], [552.0928959948999, -93.44094197460001], [548.6787228741, -88.70865865910002]], [[548.6787228741, -88.70865865910002], [550.4488015585, -87.50865869690001], [552.0928959949, -86.14487921230003], [553.6519510639, -84.69133595100001]], [[553.6519510639, -84.69133595100001], [557.9448643145, -90.51810742100002], [560.5196673830001, -97.68976073840001], [560.5275413985, -105.48188647720002]], [[560.5275413985, -105.48188647720002], [560.5275413985, -105.48188647720002], [560.5275413985, -121.47243715460002], [560.5275413985, -121.47243715460002]], [[560.5275413985, -121.47243715460002], [560.5275413985, -121.47243715460002], [566.929116, -121.47243715460002], [566.929116, -121.47243715460002]], [[566.929116, -121.47243715460002], [566.929116, -121.47243715460002], [566.9196671814001, -105.48188647720002], [566.9196671814001, -105.48188647720002]], [[566.9196671814001, -105.48188647720002], [566.897619938, -95.8173198525], [563.5669113815001, -86.959052415], [558.0488013191, -79.91495814870001]], [[558.0488013191, -79.91495814870001], [558.0488013191, -79.91495814870001], [558.0488013191, -79.9149581487], [558.0488013191, -79.9149581487]], [[558.0488013191, -79.9149581487], [558.0488013191, -79.9149581487], [558.0488013191, -79.9149581487], [558.0488013191, -79.9149581487]]]);
}

/**
 * Stripped down version of "bezier_v2.scad".
 * For full version, see: https://www.thingiverse.com/thing:2170645
 */

function BEZ03(u) = pow((1-u), 3);
function BEZ13(u) = 3*u*(pow((1-u),2));
function BEZ23(u) = 3*(pow(u,2))*(1-u);
function BEZ33(u) = pow(u,3);

function bezier_2D_point(p0, p1, p2, p3, u) = [
	BEZ03(u)*p0[0]+BEZ13(u)*p1[0]+BEZ23(u)*p2[0]+BEZ33(u)*p3[0],
	BEZ03(u)*p0[1]+BEZ13(u)*p1[1]+BEZ23(u)*p2[1]+BEZ33(u)*p3[1]
];

function bezier_coordinates(points, steps) = [
	for (c = points)
		for (step = [0:steps])
			bezier_2D_point(c[0], c[1], c[2],c[3], step/steps)
];

module bezier_polygon(points) {
	steps = $fn <= 0 ? 30 : $fn;
	polygon(bezier_coordinates(points, steps));
}
