CodethinkLabs/bloodlight-hardware/hardware/plots/rev2/bloodlight.pdf

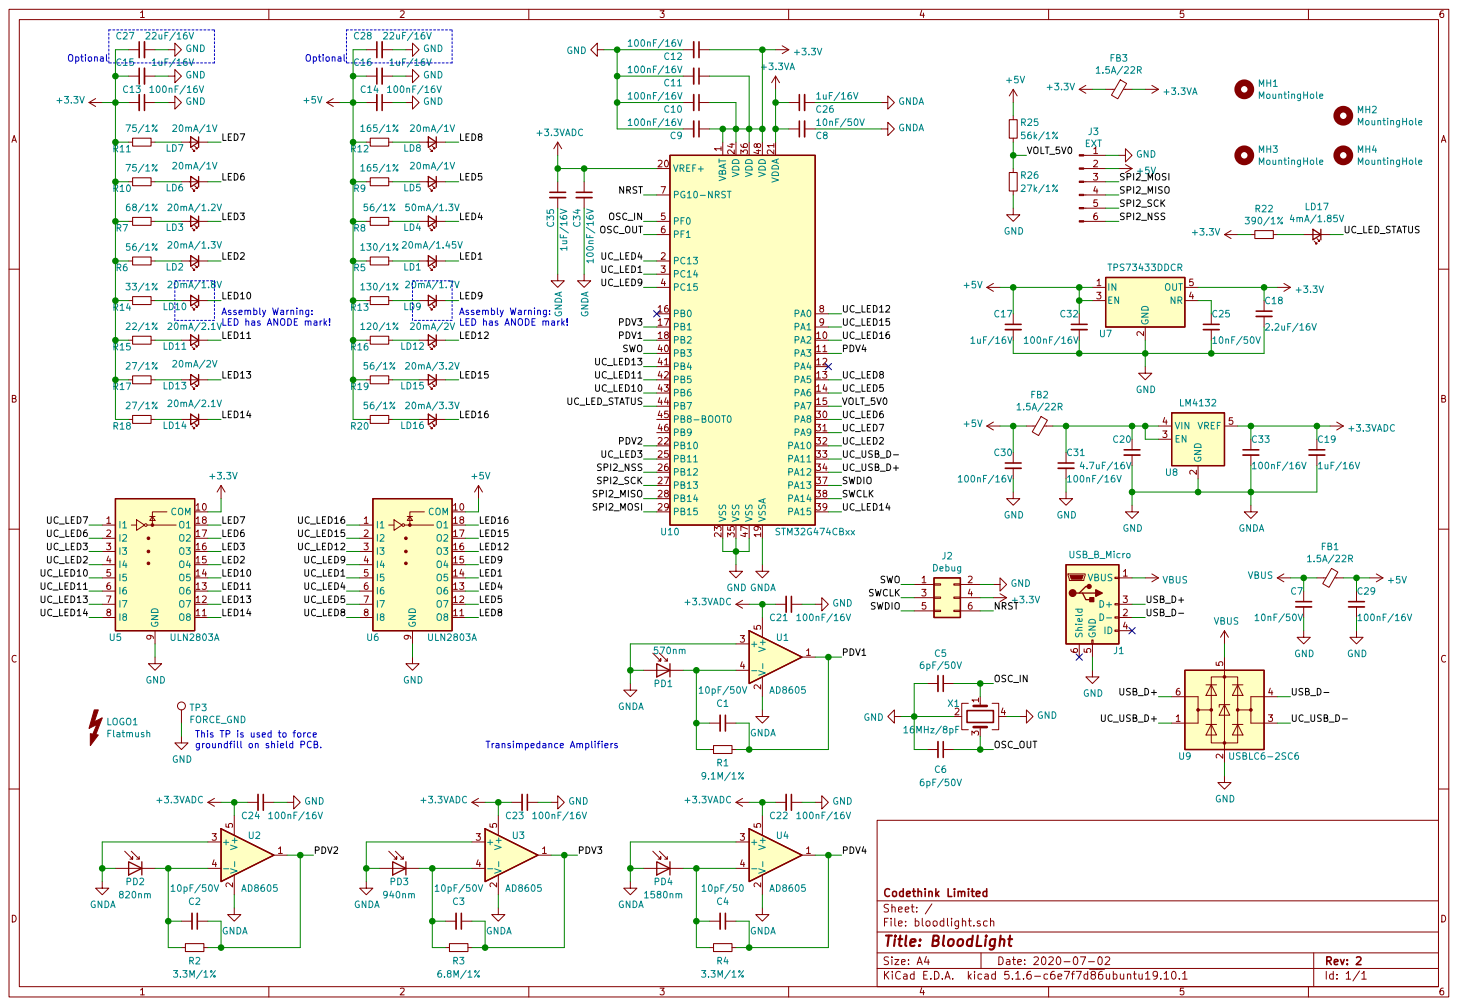
[picture p4: page 1]

1 PA2 10 PA3 11 PA4 12 PA5 13 PA6 14 PA7 15 PB0 16 PB1 17 PB2 18 VSSA 19 PC13 2 VREF+ 20 VDDA 21 PB10 22 VSS 23 VDD 24 PB11 25 PB12 26 PB13 27 PB14 28 PB15 29 PC14 3 PA8 30 PA9 31 PA10 32 PA11 33 PA12 34 VSS 35 VDD 36 PA13 37 PA14 38 PA15 39 PC15 4 PB3 40 PB4 41 PB5 42 PB6 43 PB7 44 PB8-BOOT0 45 PB9 46 VSS 47 VDD 48 PF0 5 PF1 6 PG10-NRST 7 PA0 8 PA1 9 U10 STM32G474CBxx C14 100nF/16V C7

2 EN 3 NR 4 OUT 5 U7TPS73433DDCR GNDA GND

Assembly Warning: LED has ANODE mark! This TP is used to force

LED9
Assembly Warning: LED has ANODE mark!

groundfill on shield PCB.
GND

File: bloodlight.sch Sheet: / Codethink Limited
