CodethinkLabs/bloodlight-hardware/hardware/plots/rev1/bloodlight.pdf

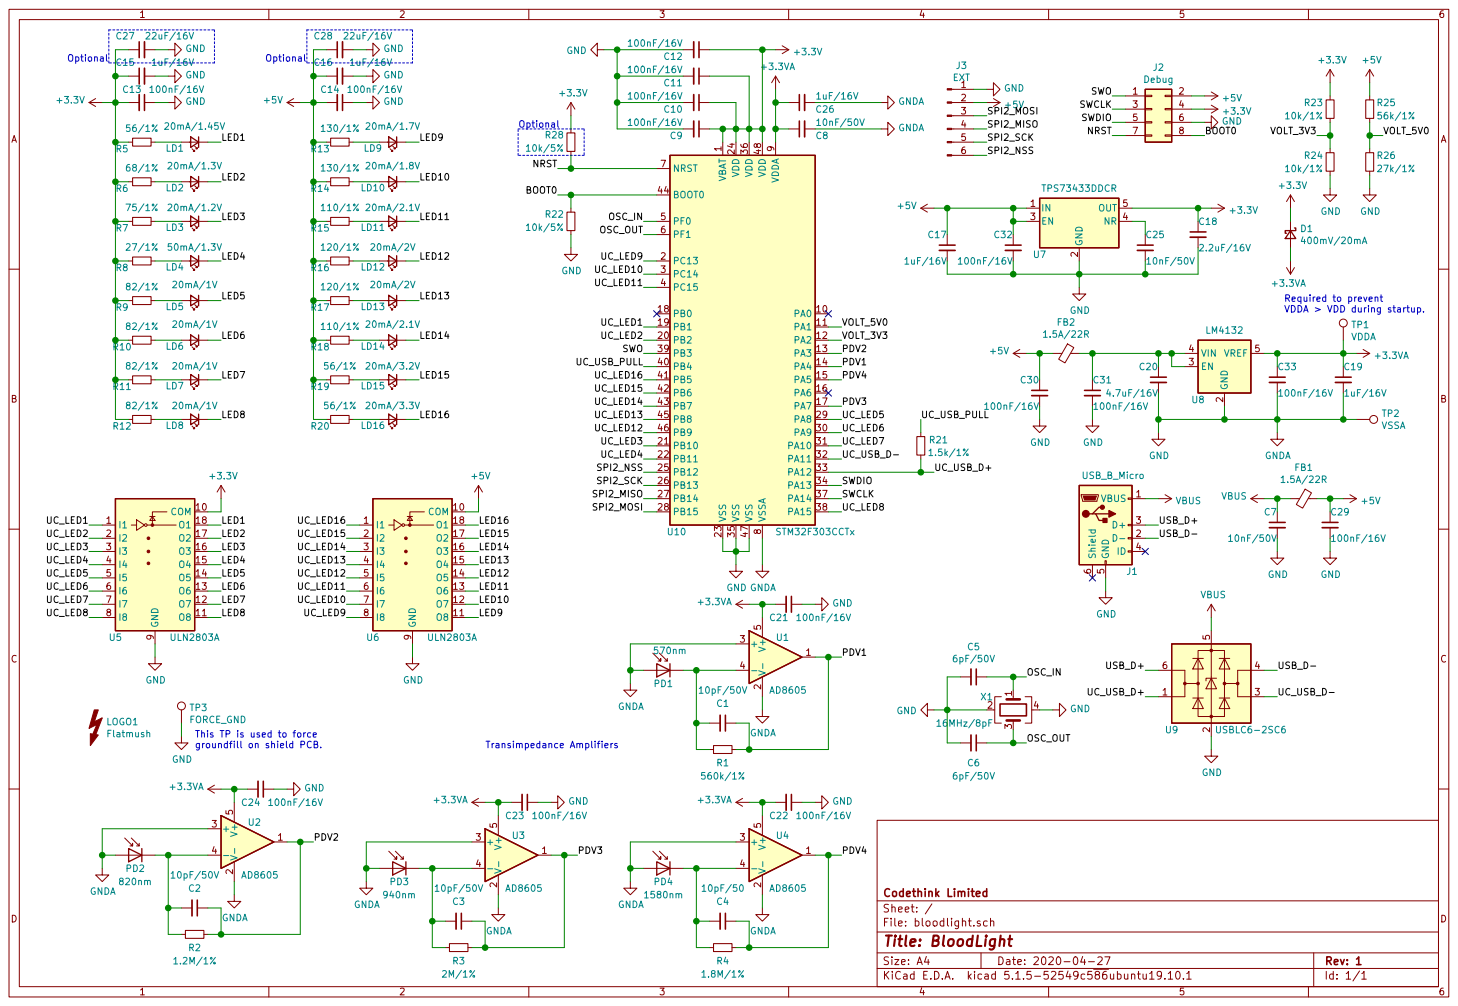
[picture p5: page 1]

9 VSS 23 VSS 35 VSS 47 VSSA U10 8STM32F303CCTx LD11

1 VDD 24 VDD 36 VDD 48 VDDA

VDDA > VDD during startup.

This TP is used to force
groundfill on shield PCB.

File: bloodlight.sch Sheet: / Codethink Limited
