CodethinkLabs/bloodlight-hardware/(commit log)

2020-04-21 Add slightly outdated document listing available LED wavelengths
2020-04-27 Initial hardware design
    [bloodlight.kicad_pcb, bloodlight.sch]
2020-04-28 Annotate headers and add revision info to silkscreen
    [bloodlight.kicad_pcb]
2020-04-28 Add light shield PCB
    [bloodlight.kicad_pcb, bloodlight.sch]
2020-04-28 Add bypass capacitors to TIA opamps
    [bloodlight.kicad_pcb, bloodlight.sch]
2020-04-28 Fix silkscreen around amplifiers
    [bloodlight.kicad_pcb]
2020-04-29 Update LED survey
    [LED.ods]
2020-04-29 Add photodiode ranges to survey
    [LED.ods]
2020-04-29 Linearly interpolate photodiode ranges in survey
    [LED.ods]
2020-04-29 Update LED survey to match LED to most sensitive photodiode
    [LED.ods]
2020-04-30 Swap PD1 and PD2 for locality of wavelengths
    [LED.ods, bloodlight.kicad_pcb, bloodlight.sch]
2020-04-30 Configure TIA resistors and capacitors
    [TIA.ods, bloodlight.kicad_pcb, bloodlight.sch]
2020-04-30 Make LED selection
    [LED.ods]
2020-04-30 Implement LED selection
    [LED.ods, bloodlight.kicad_pcb, bloodlight.sch]
2020-04-30 Switch all caps to ceramics as datasheets require
    [bloodlight.kicad_pcb, bloodlight.sch]
2020-05-01 Switch to low noise LDO
    [bloodlight.kicad_pcb, bloodlight.sch]
2020-05-01 Connect COM pin to VCC as suggested by bjdooks review
    [bloodlight.kicad_pcb, bloodlight.sch]
2020-05-01 Add pull up to NRST as suggested in bjdooks review
    [bloodlight.kicad_pcb, bloodlight.sch]
2020-05-04 Replace status LED with configurable USB pull up
    [bloodlight.kicad_pcb, bloodlight.sch]
2020-05-04 Make voltage dividers 0402 and improve 5V range
    [bloodlight.kicad_pcb, bloodlight.sch]
2020-05-04 Use lower capacitance crystal and improve grounding around it
    [bloodlight.kicad_pcb, bloodlight.sch]
2020-05-04 Add large optional bulk capacitors for LEDs
    Suggested by Ben Dooks
    [bloodlight.kicad_pcb, bloodlight.sch]
2020-05-04 Add capacitors to ferrites to for pi filter
    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
    [bloodlight.kicad_pcb, bloodlight.sch]
2020-05-04 Add additional filtering to regulators
    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
    [bloodlight.kicad_pcb, bloodlight.sch]
2020-05-04 Make USB pull resistor 0402 and improve grounding
    [bloodlight.kicad_pcb, bloodlight.sch]
2020-05-04 Fix minor silkscreen error with R23 and R24
    [bloodlight.kicad_pcb]
2020-05-05 Update LED footprints
    [bloodlight.kicad_pcb, bloodlight.sch]
2020-05-05 Remove unused SOT-23 rounded footprint
2020-05-05 OpAmp footprint fix and other minor fixes
    [bloodlight.kicad_pcb, bloodlight.sch]
2020-05-05 Fix silkscreen for OpAmp footprint update
    [bloodlight.kicad_pcb]
2020-05-06 Changed vias for manufacturability
    [bloodlight.kicad_pcb]
2020-05-06 Add instructions for manufacturing
    [bloodlight.kicad_pcb, bloodlight.sch]
2020-05-06 Add missing URL to BOM
2020-05-06 Fix some minor silkscreen issues
    [bloodlight.kicad_pcb]
2020-05-06 Fix minor typo in BOM which lead to placement error
2020-05-06 Add rev1 manufacturing files
    [bom.csv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]
2020-05-15 Fix typo in pin allocation
2020-05-19 8-pin not 6-pin header for debug (BOM fix)
2020-05-19 Add warning about LD10 and the faulty OSRAM marker
    [bloodlight.sch]
2020-05-19 Fix diode reversal in placement patch
2020-05-22 Document OPAMP limitations for STM32F303
2020-05-29 Add alternative opamp configs to pin alloc to workaround opamp issue
2020-06-26 Remove NRST pull-up (R28)
    [bloodlight.kicad_pcb, bloodlight.sch]
2020-06-26 Remove BOOT0 pull-down (R22)
    [bloodlight.kicad_pcb, bloodlight.sch]
2020-06-26 Remove 5V and BOOT0 from debug header as they're not needed
    [bloodlight.kicad_pcb, bloodlight.sch]
2020-06-26 Remove 3.3V voltage divider to enable OPAMP1
    [bloodlight.kicad_pcb, bloodlight.sch]
2020-06-26 Revision 2 major hardware changes
    [bloodlight.kicad_pcb, bloodlight.sch]
2020-06-26 Add screw holes and 90-degree debug header
    [bloodlight.kicad_pcb, bloodlight.sch]
2020-06-26 Add status LED and fix debug header in BOM
    [bloodlight.kicad_pcb, bloodlight.sch]
2020-06-26 Improve LED wavelength locality and resistors
    [bloodlight.kicad_pcb, bloodlight.sch]
2020-06-26 Remove status LED from TODO list as it's implemented
2020-06-26 Move shield PCB to allow panelization script to run
    [bloodlight.kicad_pcb]
2020-06-26 Move PD4 to an OPAMP which supports biasing
    [bloodlight.kicad_pcb, bloodlight.sch]
2020-06-26 TIA resistor tweaking to default to better amplification
    [TIA.ods, bloodlight.sch]
2020-07-02 Update revision comments and add credits to board
    [bloodlight.kicad_pcb, bloodlight.sch]
2020-07-02 Fix BOM error with C35
2020-07-02 Remove unused components from BOM
2020-07-03 Increase break-off spacing to 4mm as requested by board house
    [bloodlight.kicad_pcb]
2020-07-22 First pass at case
    Currently lacking fixings for a strap
    [case-parts.scad, case.scad]
2020-07-22 Add strap "wings" to the top of the case
    [case.scad]
2020-07-22 Add hole for USB and debug connectors
    [case.scad]
2020-07-22 Add a hole for the SPI port & some "cooling" holes
    [case.scad]
2020-07-22 Add logo and text to case
    [case.scad, codethink-logo-def.scad]
2020-07-22 Fixes for connectors
    Also allow for countersunk screws for fixing the base
    [case-parts.scad, case.scad]
2020-07-24 Printability Changes
    Re-oriented the case for printability - bridging to print the inside of
    the case is easy, supporting the entire case on the codethink logo
    isn't.
    The text on the back wasn't printable, so i've commented it out, makes
    for a smaller stl.
    [case.scad]
2020-07-27 Make commenting of text more explicit
    [case.scad]
2020-07-27 Increase LED hole size
    [case.scad]
2020-09-28 case: Move the case's strap wings up
    The case's strap wings are currently too low - the thickness of the
    straps will cause the case to lift up, while we want to keep pressure on
    the arm so that light doesn't spill over from the LEDs into the
    photodiodes.
    This commit moves the strap up above the vents, and shortens the wings
    so that they don't block the SPI connector hole.
    [case.scad]
2020-09-28 case: remove redundant cutout from the strap wings
    The cutouts appear to be to make space for the insides of the case,
    but this is also accomplished by cutting out the entire inside of the
    case before filling in its contents
    [case.scad]
2020-10-14 case: Add screw models to check fit in the case
    [case-parts.scad, case.scad]
2020-10-14 case: Make the screw holes fit the screws flush with the case
    [case-parts.scad, case.scad]
2020-10-14 Replace codethink logo with a bloodlight logo
    The codethink logo is hard to print on a 3D printer at that scale
    [case.scad]
2020-10-14 Add instructions and tooling to convert the kicad board to stl
2020-11-10 case: Model the flat edges at the top of screws
    [case-parts.scad]
2020-11-10 case: make the screw holes slightly tighter for better screw threading
    [case-parts.scad]
2021-01-12 Add revision 2 manufacturing files
    [bom.csv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]
